DeltaLabo/cell_charger_discharger/pcb/cellSwitcherV6.xlsx

Part List |  |  |  |  |  |  |  | To take from inventory |  |  |  |  |  | To buy |  |  |  |  |  |  |  |  |  |  |  | FOR RS |  | FOR PBAN |  |  |  |  |  | SMD / DIP | Package
Qty | Name | Device | Value | Package | Parts | SMD / DIP | Pads / Pins | Bag | Available | Need | Balance | Specifications | Manufacturer | Vendor | Vendor SN | Manufacurer PN | Package type | Needed | Minimum | Actual | Inventory before | Inventory now | Unit cost | Total
4 | NPN transistor | BC818K-40 |  | SOT-23 | BJT1, BJT2, BJT3, BJT4 | SMD | 3 | A28 | 93 | 30 | 63 |  | Infineon |  |  | BC818K40E6327HTSA1 |  |  |  |  |  |  |  |  |  |  |  | Infineon | NPN transistor | BC818K40E6327HTSA1 | BJT1, BJT2, BJT3, BJT4 | 4 | 3 | SMD | SOT-23
1 | Non-polarized capacitor | NONPOL_CAP-0603 | 1n | C0603 | C1 | SMD | 2 | B37 | 93 | 12 | 81 |  | TDK |  |  | C1608X7R1H102K080AE |  |  |  |  |  |  |  |  |  |  |  | TDK | Non-polarized capacitor | C1608X7R1H102K080AE | C1 | 1 | 2 | SMD | C0603
2 | Non-polarized capacitor | NONPOL_CAP-0603 | 0.1u | C0603 | C2, C3 | SMD | 2 | B03 | 93 | 18 | 75 |  | TDK |  |  | C1608X8R1H104K080AB |  |  |  |  |  |  |  |  |  |  |  | TDK | Non-polarized capacitor | C1608X8R1H104K080AB | C2, C3 | 2 | 2 | SMD | C0603
1 | Non-polarized capacitor | NONPOL_CAP-0603 | 0.33u | C0603 | C4 | SMD | 2 | A25 | 34 | 12 | 22 |  | Murata |  |  | GRM21BR71C334KA01L |  |  |  |  |  |  |  |  |  |  |  | Murata | Non-polarized capacitor | GRM21BR71C334KA01L | C4 | 1 | 2 | SMD | C0603
1 | Non-polarized capacitor | NONPOL_CAP-0603 | 1u | C0603 | C5 | SMD | 2 | B04 | 8 | 12 | -4 |  | TDK |  |  | CGA4J3X7R1H105K125AB |  |  |  |  |  |  |  |  |  |  |  | TDK | Non-polarized capacitor | CGA4J3X7R1H105K125AB | C5 | 1 | 2 | SMD | C0603
1 | Non-polarized capacitor | NONPOL_CAP-0603 | 10u | C0603 | C6 | SMD | 2 | B06 | 32 | 12 | 20 |  | Murata |  |  | GRM188R61E106MA73D |  |  |  |  |  |  |  |  |  |  |  | Murata | Non-polarized capacitor | GRM188R61E106MA73D | C6 | 1 | 2 | SMD | C0603
2 | Li-Ion cell holder | 2_18650_HOLDER |  |  | CH1, CH2 | DIP | 2 | C1 | 12 | 9 | 3 |  | Keystone |  |  | 1049P |  |  |  |  |  |  |  |  |  |  |  | Keystone | Li-Ion cell holder | 1049P | CH1, CH2 | 2 | 2 | DIP
2 | Ni-MH cell holder | 2_AA_HOLDER |  |  | CH1, CH2 | DIP | 2 |  |  |  |  | Bulgin PCB mounting battery holder, AA size X 1 BX0035 AA battery 1 PCB | Bulgin | RS | 489-908 | BX0035 |  | 9 | 1 | 9 | 0 | 0 | ¥392.00 | ¥3528.00 | https://jp.rs-online.com/web/p/battery-holders-mounts/0489908/ | 489-908 | 9 | Bulgin | Ni-MH cell holder | BX0035 | CH1, CH2 | 2 | 2 | DIP
1 | Connector | TMM-110-01-F-D-RA |  |  | CON1 | DIP | 20 |  |  |  |  | 20 Positions Header Connector 0.079 "(2.00 mm) Through Hole, Right Angle Gold | SAMTEC | Digi-Key | TMM-110-01-FD-RA-ND | TMM-110-01-FD-RA |  | 12 | 1 | 12 | 0 | 0 | ¥229.00 | ¥2748.00 | https://www.digikey.jp/product-detail/ja/samtec-inc/TMM-110-01-F-D-RA/TMM-110-01-F-D-RA-ND/2685424 | TMM-110-01-FD-RA-ND | 12 | SAMTEC | Connector | TMM-110-01-FD-RA | CON1 | 1 | 20 | DIP
4 | Switching diode | BAQ133-GS08 |  | SOD08 | D1, D2, D3, D4 | SMD | 2 | A44 | 78 | 30 | 48 |  | Vishay |  |  | BAQ133-GS08 |  |  |  |  |  |  |  |  |  |  |  | Vishay | Switching diode | BAQ133-GS08 | D1, D2, D3, D4 | 4 | 2 | SMD | SOD08
1 | Fuse holder | FUSEHOLDER |  |  | F1 | DIP | 2 | A38 | 10 | 12 | -2 | Schurter PCB mounting fuse holder 10A for 5 x 20 mm cartridge fuse 250V ac 0031.8201 | Schurter | RS | 176-9047 | 31.8201 |  | 2 | 10 | 10 | 0 | 8 | ¥97.40 | ¥974.00 | https://jp.rs-online.com/web/p/pcb-mounts/1769047/ | 176-9047 | 10 | Schurter | Fuse holder | 31.8201 | F1 | 1 | 2 | DIP
4 | Relay | RTE24005F |  |  | K1, K2, K3, K4 | DIP | 8 | A66 | 24 | 30 | -6 | TE Connectivity Relay 5V dc, 2c contact PCB mounting type | TE Connectivity | RS | 782-1261 | RTE24005F |  | 6 | 1 | 6 | 0 | 0 | ¥316.00 | ¥1896.00 | https://jp.rs-online.com/web/p/pcb-mounts/1769047/ | 782-1261 | 6 | TE Connectivity | Relay | RTE24005F | K1, K2, K3, K4 | 4 | 8 | DIP
4 | LED | LGR971 |  | SML0805 | LED1, LED2, LED3, LED4 | SMD | 2 | A49 | 32 | 30 | 2 |  | OSRAM Opto Semiconductors |  |  | LGR971 |  |  |  |  |  |  |  |  |  |  |  | OSRAM Opto Semiconductors | LED | LGR971 | LED1, LED2, LED3, LED4 | 4 | 2 | SMD | SML0805
1 | Muxer | ADG704BRM |  | MSOP10 | MUX1 | SMD | 10 | A52 | 7 | 12 | -5 | Analog Devices Single 4: 1 Multiplexer 3 V, 5 V, 10-Pin MSOP | Analog Devices | RS | 523-8761 | ADG704BRMZ |  | 5 | 1 | 5 | 0 | 0 | ¥327.00 | ¥1635.00 | https://jp.rs-online.com/web/p/multiplexer-switch-ics/5238761/ | 523-8761 | 5 | Analog Devices | Muxer | ADG704BRMZ | MUX1 | 1 | 10 | SMD | MSOP10
1 | NAND gate | SN74LVC2G00DCUT |  | VSSOP-8 | NAND1 | SMD | 8 | A48 | 16 | 12 | 4 |  | Texas Instruments |  |  | SN74LVC2G00DCUT |  |  |  |  |  |  |  |  |  |  |  | Texas Instruments | NAND gate | SN74LVC2G00DCUT | NAND1 | 1 | 8 | SMD | VSSOP-8
1 | OptoCoupler | PS2502-4 |  | DIL16 | OK1 | DIP | 16 | A50 | 12 | 12 | 0 |  | Renesas Electronics |  |  | PS2502-4-A |  |  |  |  |  |  |  |  |  |  |  | Renesas Electronics | OptoCoupler | PS2502-4-A | OK1 | 1 | 16 | DIP | DIL16
4 | Resistor | RESISTOR-0603 | 1k | R0603 | R1, R2, R3, R4 | SMD | 2 |  |  |  |  | TE Connectivity Thick Film Surface Mount Resistors, 0.1 W, 1 kΩ, ± 1% | TE Connectivity | RS | 213-2266 | CRG0603F1K0 |  | 30 | 50 | 50 | 0 | 20 | ¥3.90 | ¥195.00 | https://jp.rs-online.com/web/p/surface-mount-fixed-resistors/2132266 | 213-2266 | 50 | TE Connectivity | Resistor | CRG0603F1K0 | R1, R2, R3, R4 | 4 | 2 | SMD | R0603
4 | Resistor | RESISTOR-0603 | 510 | R0603 | R1.1, R2.1, R3.1, R4.1 | SMD | 2 | A93 | 29 | 30 | -1 |  | Vishay |  |  | CRCW0603510RFKEA |  |  |  |  |  |  |  |  |  |  |  | Vishay | Resistor | CRCW0603510RFKEA | R1.1, R2.1, R3.1, R4.1 | 4 | 2 | SMD | R0603
1 | Resistor | RESISTOR-0603 | 0 | R0603 | R5 | SMD | 2 | B22 | 27 | 12 | 15 |  | Vishay |  |  | CRCW06030000Z0EB |  |  |  |  |  |  |  |  |  |  |  | Vishay | Resistor | CRCW06030000Z0EB | R5 | 1 | 2 | SMD | R0603
1 | Regulator | NCV7805BD2TG |  | D2PAK-3 | REG2 | SMD | 3 | B32 | 27 | 12 | 15 |  | ON Semiconductor |  |  | NCV7805BD2TG |  |  |  |  |  |  |  |  |  |  |  | ON Semiconductor | Regulator | NCV7805BD2TG | REG2 | 1 | 3 | SMD | D2PAK-3
4 | Temperature sensor | STLM20DD9F |  | UDFN-4L | TS1, TS2, TS3, TS4 | SMD | 4 |  |  |  |  | STMicroelectronics Temperature Sensor IC, ± 1.5 ° C, Analog, 2.4 to 5.5 V, 4-Pin UDFN Temperature | STMicroelectronics | RS | 686-4973 | STLM20DD9F | UDFN-4L | 30 | 5 | 30 | 0 | 0 | ¥90.80 | ¥2724.00 | https://jp.rs-online.com/web/p/temperature-sensors-humidity-sensors/6864973/ | 686-4973 | 30 | STMicroelectronics | Temperature sensor | STLM20DD9F | TS1, TS2, TS3, TS4 | 4 | 4 | SMD | UDFN-4L
3 | Fuses |  | 4A |  |  |  |  |  |  |  |  | Littelfuse glass tube fuse 4A (time lag) 239 series 5x20mm 5 x 20mm 125V ac | Littlefuse | RS | 523-4725 | 0239004.MXP |  | 24 | 30 | 30 | 0 | 6 | ¥81.40 | ¥2442.00 | https://jp.rs-online.com/web/p/cartridge-fuses/5234725/ | 523-4725 | 30
1 | PCB fabrication |  |  |  |  |  |  |  |  |  |  | PCB fabrication - 2 layers - With soldering service | P-ban | P-ban |  |  |  | 1 | 1 | 1 | 0 | 0 |  | ¥0.00
TOTAL |  | ¥16142.00
