DeltaLabo/cell_charger_discharger/pcb/chargerDischarger.V5.xlsx

Part List |  |  |  |  |  |  |  | To take from inventory |  |  |  |  |  | To buy |  |  |  |  |  |  |  |  |  |  |  | FOR RS |  | FOR PBAN |  |  |  |  |  | SMD / DIP | Package
Qty | Name | Device | Value | Package | Parts | SMD / DIP | Leads / Pins | Bag | Available | Need | Balance | Specifications | Manufacturer | Vendor | Vendor SN | Manufacurer PN | Package type | Needed | Minimum | Actual | Inventory before | Inventory now | Unit cost | Total
3 | NPN transistor | BC818K-40 |  | SOT-23 | BJT101, BJT102, BJT103 | SMD | 3 | A28 | 105 | 12 | 93 |  | Infineon |  |  | BC818K40E6327HTSA1 | SOT-23 |  |  |  |  |  |  |  |  |  |  | Infineon | NPN transistor | BC818K40E6327HTSA1 | BJT101, BJT102, BJT103 | 3 | 3 | SMD | SOT-23
13 | Non-polarized capacitor | NONPOL_CAP-0603 | 1u | C0603 | C1, C3, C5, C6, C7, C101, C102, C103, C210, C214, C302, C304, C403 | SMD | 2 | B33 |  |  |  | TDK MLCC 1μF 50V dc ± 10% | TDK | RS | 903-8720 | CGA4J3X7R1H105K125AB | C0603 | 42 | 50 | 50 | 0 | 8 | ¥26.76 | ¥1338.00 | https://jp.rs-online.com/web/p/mlccs-multilayer-ceramic-capacitors/9038720/ | 903-8720 | 50 | TDK | Non-polarized capacitor | CGA4J3X7R1H105K125AB | C1, C3, C5, C6, C7, C101, C102, C103, C210, C214, C302, C304, C403 | 13 | 2 | SMD | C0603
4 | Non-polarized capacitor | NONPOL_CAP-0603 | 10u | C0603 | C2, C10, C303, C405 | SMD | 2 |  |  |  |  | Murata MLCC 10μF 25V dc ± 20% | Murata | RS | 790-2723 | GRM188R61E106MA73D | C0603 | 15 | 25 | 25 | 0 | 10 | ¥29.12 | ¥728.00 | https://jp.rs-online.com/web/p/mlccs-multilayer-ceramic-capacitors/7902723/ | 790-2723 | 25 | Murata | Non-polarized capacitor | GRM188R61E106MA73D | C2, C10, C303, C405 | 4 | 2 | SMD | C0603
3 | Non-polarized capacitor | NONPOL_CAP-0603 | 10u | C1210 | C201, C202, C203 | SMD | 2 |  |  |  |  | TDK MLCC 10μF 50V dc ± 10% | TDK | RS | 915-5446 | CGA6P3X7S1H106K250AE | C1210 | 12 | 25 | 25 | 0 | 13 | ¥210.20 | ¥5255.00 | https://jp.rs-online.com/web/p/mlccs-multilayer-ceramic-capacitors/9155446/ | 915-5446 | 25 | TDK | Non-polarized capacitor | CGA6P3X7S1H106K250AE | C201, C202, C203 | 3 | 2 | SMD | C1210
6 | Polarized capacitor | POL_CAP-7343 | 33u | C7343 | C204, C205, C206, C215, C216, C217 | SMD | 2 | A82 |  |  |  | KEMET 33μF 25V dc Tantalum Capacitor Polymer Solid ±20% Tolerance T521 Series | KEMET | RS | 121-3317 | T521D336M025ATE040 | C7343 | 21 | 50 | 50 | 0 | 29 | ¥121.40 | ¥6070.00 | https://jp.rs-online.com/web/p/tantalum-capacitors/1213317/ | 121-3317 | 50 | KEMET | Polarized capacitor | T521D336M025ATE040 | C204, C205, C206, C215, C216, C217 | 6 | 2 | SMD | C7343
1 | Non-polarized capacitor | NONPOL_CAP-0603 | 10n | C0603 | C211 | SMD | 2 | A85 | 95 | 6 | 89 |  | Murata |  |  | GRM1885C1H103JA01D | C0603 |  |  |  |  |  |  |  |  |  |  | Murata | Non-polarized capacitor | GRM1885C1H103JA01D | C211 | 1 | 2 | SMD | C0603
6 | Non-polarized capacitor | NONPOL_CAP-0603 | 0.1u | C0603 | C4, C207, C218, C305, C501, C502 | SMD | 2 |  |  |  |  | TDK MLCC 100nF 50V dc ± 10% | TDK | RS | 915-9237 | C1608X8R1H104K080AB | C0603 | 21 | 100 | 100 | 0 | 79 | ¥7.74 | ¥774.00 | https://jp.rs-online.com/web/p/mlccs-multilayer-ceramic-capacitors/9159237 | 915-9237 | 100 | TDK | Non-polarized capacitor | C1608X8R1H104K080AB | C4, C207, C218, C305, C501, C502 | 6 | 2 | SMD | C0603
1 | Non-polarized capacitor | NONPOL_CAP-0603 | 0.33u | C0603 | C401 | SMD | 2 | A25 | 95 | 6 | 89 |  | Murata |  |  | GRM21BR71C334KA01L | C0603 |  |  |  |  |  |  |  |  |  |  | Murata | Non-polarized capacitor | GRM21BR71C334KA01L | C401 | 1 | 2 | SMD | C0603
1 | Non-polarized capacitor | POL_CAP-7343 | 100u | D6.3_AEC | C601 | SMD | 2 | A86 | 6 | 6 | 0 |  | Nichicon |  |  | UWT1C101MCL1GB | D6.3_AEC |  |  |  |  |  |  |  |  |  |  | Nichicon | Non-polarized capacitor | UWT1C101MCL1GB | C601 | 1 | 2 | SMD | D6.3_AEC
1 | Non-polarized capacitor | NONPOL_CAP-0603 | 1n | C0603 | C8 | SMD | 2 |  |  |  |  | TDK MLCC 1nF 50V dc ± 10% | TDK | RS | 915-9211 | C1608X7R1H102K080AE | C0603 | 6 | 100 | 100 | 0 | 94 | ¥5.98 | ¥598.00 | https://jp.rs-online.com/web/p/mlccs-multilayer-ceramic-capacitors/9159211 | 915-9211 | 100 | TDK | Non-polarized capacitor | C1608X7R1H102K080AE | C8 | 1 | 2 | SMD | C0603
1 | Audio jack | AUDIO_JACK-3.5MM |  |  | COMM | DIP | 4 | A87 | 2 | 6 | -4 | Lumberg phone jack (female) 3.5 mm through-hole stereo | Lumberg | RS | 505-1479 | KLBR 4 |  | 4 | 1 | 4 | 0 | 0 | ¥280.00 | ¥1120.00 | https://jp.rs-online.com/web/p/jack-plugs/5051479 | 505-1479 | 4 | Lumberg | Audio jack | KLBR 4 | COMM | 1 | 4 | DIP
1 | Connector | B6B-EH-A |  |  | CON1 | DIP | 6 | A88 | 2 | 6 | -4 | Pin header for JST board connection EH series 6 poles 2.5 mm single row straight | JST | RS | 515-1434 | B6B-EH-A (LF) (SN) |  | 4 | 10 | 10 | 0 | 6 | ¥25.50 | ¥255.00 | https://jp.rs-online.com/web/p/pcb-headers/5151434 | 515-1434 | 10 | JST | Connector | B6B-EH-A (LF) (SN) | CON1 | 1 | 6 | DIP
1 | Connector | SQT-110-01-F-D-RA |  |  | CON2 | DIP | 20 |  |  |  |  | Samtec Discrete Socket SQT Series 2mm 20 Pole 2 Row Through Hole SQT-110-01-FD-RA | SAMTEC | RS | 180-1847 | SQT-110-01-FD-RA |  | 6 | 1 | 6 | 0 | 0 | ¥467.00 | ¥2802.00 | https://jp.rs-online.com/web/p/pcb-sockets/1801847/ | 180-1847 | 6 | SAMTEC | Connector | SQT-110-01-FD-RA | CON2 | 1 | 20 | DIP
3 | Switching diode | BAQ133-GS08 |  | SOD08 | D101, D102, D103 | SMD | 2 | A44 | 90 | 12 | 78 |  | Vishay |  |  | BAQ133-GS08 | SOD08 |  |  |  |  |  |  |  |  |  |  | Vishay | Switching diode | BAQ133-GS08 | D101, D102, D103 | 3 | 2 | SMD | SOD08
1 | Schottky diode | SCHOTTKY_DIODE-BAT42W |  | SOD123 | D202 | SMD | 2 | A26 | 97 | 6 | 91 |  | DiodesZetex |  |  | BAT42W-7-F | SOD123 |  |  |  |  |  |  |  |  |  |  | DiodesZetex | Schottky diode | BAT42W-7-F | D202 | 1 | 2 | SMD | SOD123
1 | Op-Amp | MAX4198 |  | SOIC-8 | DA501 | SMD | 8 | A92 | 3 | 6 | -3 | IC OPAMP DIFF 1 CIRCUIT 8SOIC | Maxim Integrated | Digi-Key | MAX4198ESA+-ND | MAX4198ESA+-ND | SOIC-8 | 3 | 1 | 3 | 0 | 0 | ¥347.00 | ¥1041.00 | https://www.digikey.com/product-detail/en/maxim-integrated/MAX4198ESA/MAX4198ESA-ND/1702090 | MAX4198ESA+-ND | 3 | Maxim Integrated | Op-Amp | MAX4198ESA+-ND | DA501 | 1 | 8 | SMD | SOIC-8
1 | Dual MOSFET Driver | MCP14628-E/SN |  | SOIC-8 | DR200 | SMD | 8 |  |  |  |  | Microchip MOSFET Driver Dual 2A, 4.5-5.5V 8-Pin SOIC Inverted, Non-Inverted MCP14628-E / SN | Microchip | RS | 668-4219 | MCP14628-E / SN | SOIC-8 | 6 | 2 | 6 | 0 | 0 | ¥205.50 | ¥1233.00 | https://jp.rs-online.com/web/p/mosfet-drivers/6684219 | 668-4219 | 6 | Microchip | Dual MOSFET Driver | MCP14628-E / SN | DR200 | 1 | 8 | SMD | SOIC-8
2 | Fuse holder | FUSEHOLDER |  |  | F1,F2 | DIP | 2 | A38 | 19 | 9 | 10 |  | Schurter |  |  | 31.8201 |  |  |  |  |  |  |  |  |  |  |  | Schurter | Fuse holder | 31.8201 | F1,F2 | 2 | 2 | DIP
1 | Common mode choke | ACM9070-701 |  |  | FIL601 | SMD | 4 |  |  |  |  | TDK common mode choke coil ACM 10 mΩ | TDK | RS | 916-4144 | ACM9070-701-2PL-TL01 |  | 6 | 2 | 6 | 0 | 0 | ¥247.00 | ¥1482.00 | https://jp.rs-online.com/web/p/emi-rfi-inductor-components/9164144/ | 916-4144 | 6 | TDK | Common mode choke | ACM9070-701-2PL-TL01 | FIL601 | 1 | 4 | SMD
1 | Relay | ORWH |  |  | K101 | DIP | 5 | A72 | 8 | 6 | 2 |  | TE Connectivity |  |  | ORWH-SH-105D1F |  |  |  |  |  |  |  |  |  |  |  | TE Connectivity | Relay | ORWH-SH-105D1F | K101 | 1 | 5 | DIP
1 | Relay | RT424F05054 |  |  | K102 | DIP | 9 |  |  |  |  | TE Connectivity Latching Relay DPDT 5V dc | TE Connectivity | RS | 680-3883P | RT424F05 |  | 6 | 1 | 6 | 0 | 0 | ¥870.00 | ¥5220.00 | https://jp.rs-online.com/web/p/latching-relays/6803883P/ | 680-3883P | 6 | TE Connectivity | Relay | RT424F05 | K102 | 1 | 9 | DIP
2 | Power Inductor | INDUCTOR-60B8683C | 68u |  | L203, L204 | SMD | 2 |  |  |  |  | Murata Power Solutions Wirewound Inductors (face mount), 68 μH, 9A, 27 x 19.5 x 20 mm | Murata | RS | 749-6405 | 60B683C |  | 9 | 1 | 9 | 0 | 0 | ¥356.00 | ¥3204.00 | https://jp.rs-online.com/web/p/wire-wound-surface-mount-inductors/7496405/ | 749-6405 | 9 | Murata | Power Inductor | 60B683C | L203, L204 | 2 | 2 | SMD
3 | LED | LGR971 |  | SML0805 | LED101, LED102, LED103 | SMD | 2 | A49 | 44 | 12 | 32 |  | OSRAM |  |  | LGR971 | SML0805 |  |  |  |  |  |  |  |  |  |  | OSRAM | LED | LGR971 | LED101, LED102, LED103 | 3 | 2 | SMD | SML0805
2 | N-Channel MOSFET | SI4154DY |  | SOIC-8 | MF201, MF202 | SMD | 8 |  |  |  |  | N-Ch MOSFET SO-8 BWL 40 V 3.3 mohm @ 10 V- | Vishay | RS | 180-7965 | SI4154DY-T1-GE3 | SOIC-8 | 9 | 10 | 10 | 0 | 1 | ¥175.80 | ¥1758.00 | https://jp.rs-online.com/web/p/mosfets/1807965/ | 180-7965 | 10 | Vishay | N-Channel MOSFET | SI4154DY-T1-GE3 | MF201, MF202 | 2 | 8 | SMD | SOIC-8
3 | OptoCoupler | PS2502-1 |  | DIL04 | OK101, OK102, OK103 | DIP | 4 |  |  |  |  | Isocom Photocoupler AC input 1, 4-Pin through hole mounting | Isocom | RS | 161-1266 | PS2502-1X | DIL04 | 12 | 20 | 20 | 0 | 8 | ¥64.65 | ¥1293.00 | https://jp.rs-online.com/web/p/optocouplers/1611266/ | 161-1266 | 20 | Isocom | OptoCoupler | PS2502-1X | OK101, OK102, OK103 | 3 | 4 | DIP | DIL04
1 | Power jack | 722RA |  |  | PC1 | DIP | 3 |  |  |  |  | Switchcraft DC Power Socket 2mm 5A Through Hole 12 V dc 722RA | Switchcraft | RS | 705-1516 | 722RA |  | 6 | 1 | 6 | 0 | 0 | ¥345.00 | ¥2070.00 | https://jp.rs-online.com/web/p/optocouplers/1611266/ | 705-1516 | 6 | Switchcraft | Power jack | 722RA | PC1 | 1 | 3 | DIP
1 | 8-bit MCU | PIC16F1786-I/SS |  | SPDIP-28 | PIC1 | DIP | 28 |  |  |  |  | Microchip Microcomputer PIC16F 8-bit RISC, 28-Pin SDPIP | Microchip | RS | 803-2434 | PIC16F1786-I / SP | SPDIP-28 | 6 | 10 | 10 | 0 | 4 | ¥311.00 | ¥3110.00 | https://jp.rs-online.com/web/p/microcontrollers/8032434 | 803-2434 | 10 | Microchip | 8-bit MCU | PIC16F1786-I / SP | PIC1 | 1 | 28 | DIP | SPDIP-28
3 | Power Resistor | TO-220_RESISTOR | 1 | TO-220 | PR701, PR702, PR703 | DIP | 4 |  |  |  |  | Vishay Power Resistor LTO 50 Series 1 Ω 50 W ą 5% | Vishay | RS | 532-8369 | LTO 050 F 1 R 000 JTE 3 | TO-220 | 12 | 1 | 12 | 0 | 0 | ¥838.00 | ¥10056.00 | https://jp.rs-online.com/web/p/through-hole-fixed-resistors/5328369/ | 532-8369 | 12 | Vishay | Power Resistor | LTO 050 F 1 R 000 JTE 3 | PR701, PR702, PR703 | 3 | 4 | DIP | TO-220
2 | Resistor | RESISTOR-0603 | 0 | R0603 | R1, R2 | SMD | 2 | B22 |  |  |  | Vishay thick film surface mount resistor, 0.1 W, 0 Ω, ± 1% | Vishay | RS | 678-9670 | CRCW06030000Z0EB | R0603 | 9 | 50 | 50 | 0 | 41 | ¥1.34 | ¥67.00 | https://jp.rs-online.com/web/p/surface-mount-fixed-resistors/6789670/ | 678-9670 | 50 | Vishay | Resistor | CRCW06030000Z0EB | R1, R2 | 2 | 2 | SMD | R0603
4 | Resistor | RESISTOR-0603 | 1k | R0603 | R101, R103, R106, R202 | SMD | 2 | A21 | 26 | 15 | 11 |  | TE Connectivity |  |  | CRG0603F1K0 | R0603 |  |  |  |  |  |  |  |  |  |  | TE Connectivity | Resistor | CRG0603F1K0 | R101, R103, R106, R202 | 4 | 2 | SMD | R0603
3 | Resistor | RESISTOR-0603 | 510 | R0603 | R102, R104, R107 | SMD | 2 | A93 | 41 | 12 | 29 |  | Vishay |  |  | CRCW0603510RFKEA | R0603 |  |  |  |  |  |  |  |  |  |  | Vishay | Resistor | CRCW0603510RFKEA | R102, R104, R107 | 3 | 2 | SMD | R0603
1 | Resistor | RESISTOR-0603 | 10M | R0603 | R105 | SMD | 2 | A22 | 40 | 6 | 34 |  | Vishay |  |  | CRCW060310M0FKEA | R0603 |  |  |  |  |  |  |  |  |  |  | Vishay | Resistor | CRCW060310M0FKEA | R105 | 1 | 2 | SMD | R0603
1 | Resistor | RESISTOR-0603 | 200 | R0603 | R4 | SMD | 2 |  |  |  |  | KOA Thick Film Surface Mount Resistors, 0.125 W, 200 Ω, ± 1% | KOA | RS | 631-6222 | RK73H1JTTD2000F | R0603 | 6 | 50 | 50 | 0 | 44 | ¥7.96 | ¥398.00 | https://jp.rs-online.com/web/p/surface-mount-fixed-resistors/6316222/ | 631-6222 | 50 | KOA | Resistor | RK73H1JTTD2000F | R4 | 1 | 2 | SMD | R0603
1 | Regulator | NCV7805BD2TG |  | D2PAK-3 | REG402 | SMD | 3 |  |  |  |  | ON Semiconductor Positive Voltage 3-Terminal Regulator 5 V 1A Fixed Output Surface Mount D2PAK 3-Pin | ON Semiconductor | RS | 785-7428 | NCV7805BD2TG | D2PAK-3 | 6 | 10 | 10 | 0 | 4 | ¥82.20 | ¥822.00 | https://jp.rs-online.com/web/p/linear-voltage-regulators/7857428 | 785-7428 | 10 | ON Semiconductor | Regulator | NCV7805BD2TG | REG402 | 1 | 3 | SMD | D2PAK-3
1 | Hall-effect current sensor | ACS723-05AB-T |  | SOIC-8 | SEN301 | SMD | 8 |  |  |  |  | Hall-effect current sensor IC, 8-pin SOIC | Allegro Microsystems | RS | 866-0767 | ACS723LLCTR-05AB-T | SOIC-8 | 6 | 10 | 10 | 0 | 4 | ¥647.00 | ¥6470.00 | https://jp.rs-online.com/web/p/current-sensors/8660767/ | 866-0767 | 10 | Allegro Microsystems | Hall-effect current sensor | ACS723LLCTR-05AB-T | SEN301 | 1 | 8 | SMD | SOIC-8
2 | Voltage reference | REF195GSZ |  | SOIC-8 | VREF1, VREF302 | SMD | 8 |  |  |  |  | Analog Devices Reference Voltage IC, Output: 5V Surface Mount, 8-pin SOIC | Analog Devices | RS | 523-7011 | REF195GSZ | SOIC-8 | 9 | 10 | 10 | 0 | 1 | ¥400.00 | ¥4000.00 | https://jp.rs-online.com/web/p/voltage-references/5237011/ | 523-7011 | 10 | Analog Devices | Voltage reference | REF195GSZ | VREF1, VREF302 | 2 | 8 | SMD | SOIC-8
3 | Heatsink |  |  |  |  |  |  |  |  |  |  | For RS Pro heat sink transistor, 20 x 35 x 20 mm | RS Pro | RS | 263-251 | 263-251 |  | 10 | 10 | 10 | 0 | 0 | ¥224.00 | ¥2240.00 | https://jp.rs-online.com/web/p/heatsinks/0263251/ | 263-251 | 10
1 | FTDI chip |  |  |  |  |  |  |  |  |  |  | FTDI Chip Interface Development Kit 5 V TTL 3.5 mm Jack USB-UART Cable | FTDI Chip | RS | 687-7774 | TTL-232R-5V-AJ |  | 3 | 1 | 3 | 0 | 0 | ¥2397.00 | ¥7191.00 | https://jp.rs-online.com/web/p/interface-development-kits/6877774/ | 687-7774 | 3
1 | Adaptor |  |  |  |  |  |  |  |  |  |  | 7.5V 24W AC/DC External Wall Mount Adapter Fixed Blade Input | Triad Magnetics | Digi-Key | 237-1391-ND | WSU075-3200 |  | 4 | 1 | 4 | 0 | 0 | ¥1891.00 | ¥7564.00 | https://www.digikey.jp/products/en?keywords=237-1391-ND | 237-1391-ND | 4
1 | PCB fabrication |  |  |  |  |  |  |  |  |  |  | PCB fabrication - 2 layers - With soldering service | P-ban | P-ban |  |  |  | 1 | 1 | 1 | 0 | 0 |  | ¥0.00 |  |  | 1
TOTAL |  | ¥78159.00
