DeltaLabo/cell_charger_discharger/calibration/Voltage_Calibration_Disc.png

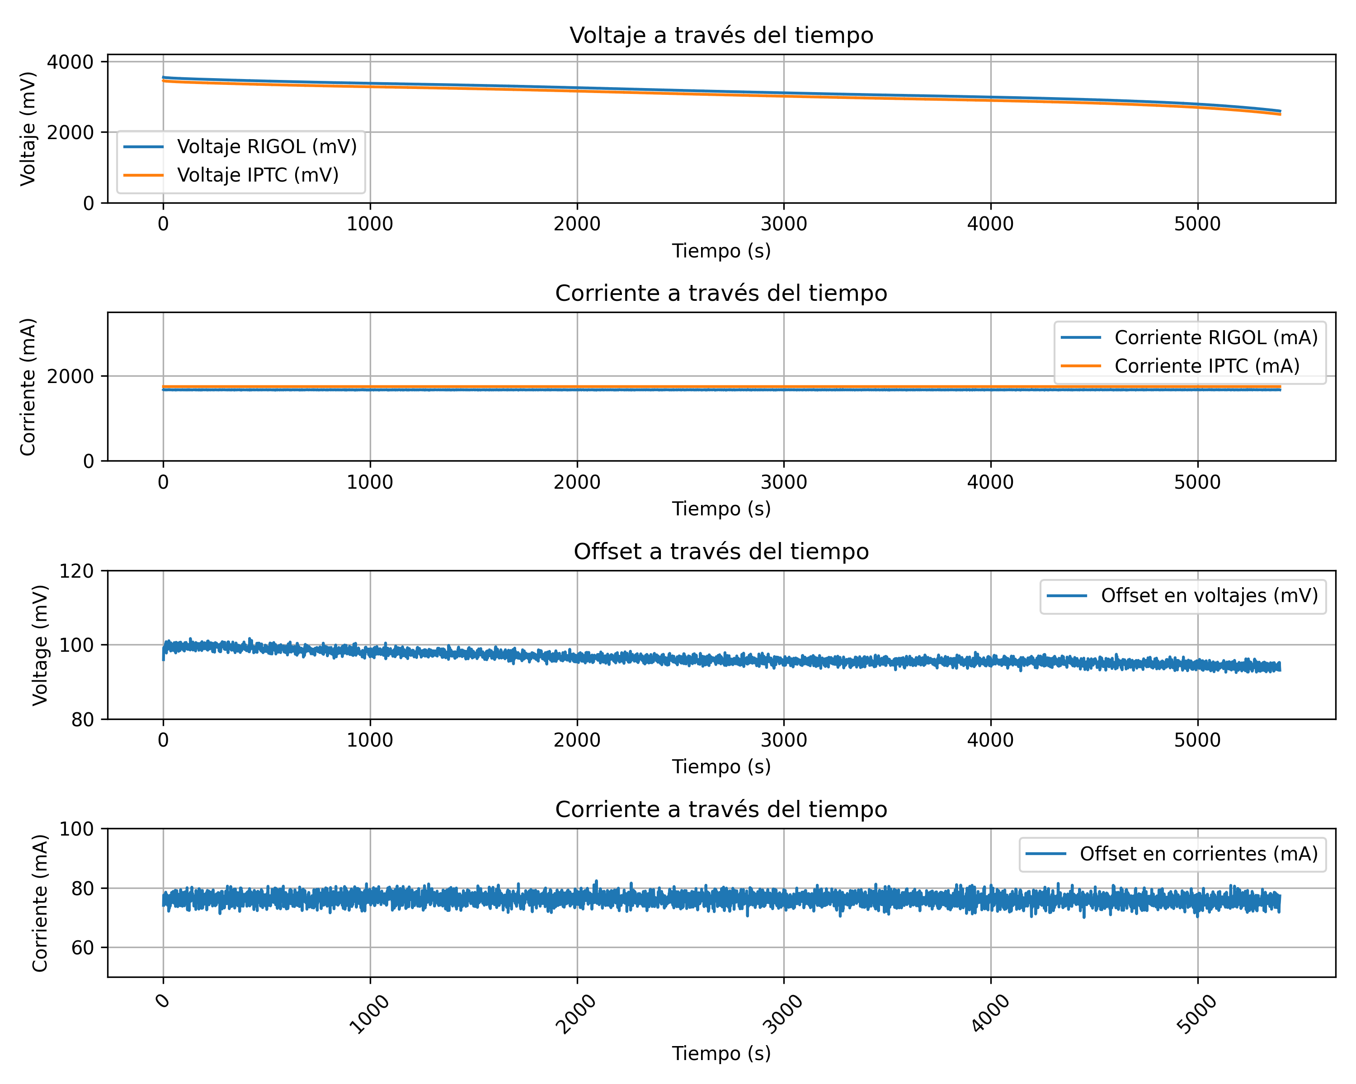
calibration/Voltage_Calibration_Disc.png
