DeltaLabo/cell_charger_discharger/pcb/cellSwitcher_ni_mh_V6_schematic.pdf

# General Block Diagram RTE²⁴⁰⁰⁵F RTE²⁴⁰⁰⁵F RTE²⁴⁰⁰⁵F RTE²⁴⁰⁰⁵F

CON1P1 CON1P2 CON1P3 CON1P4 CON1P5 CON1P6 CON1P7 CON1P8 CON1P9 CON1P10 CON1P11 CON1P12 CON1P13 CON1P14 CON1P15 CON1P16 CON1P17 CON1P18 CON1P19 CON1P20

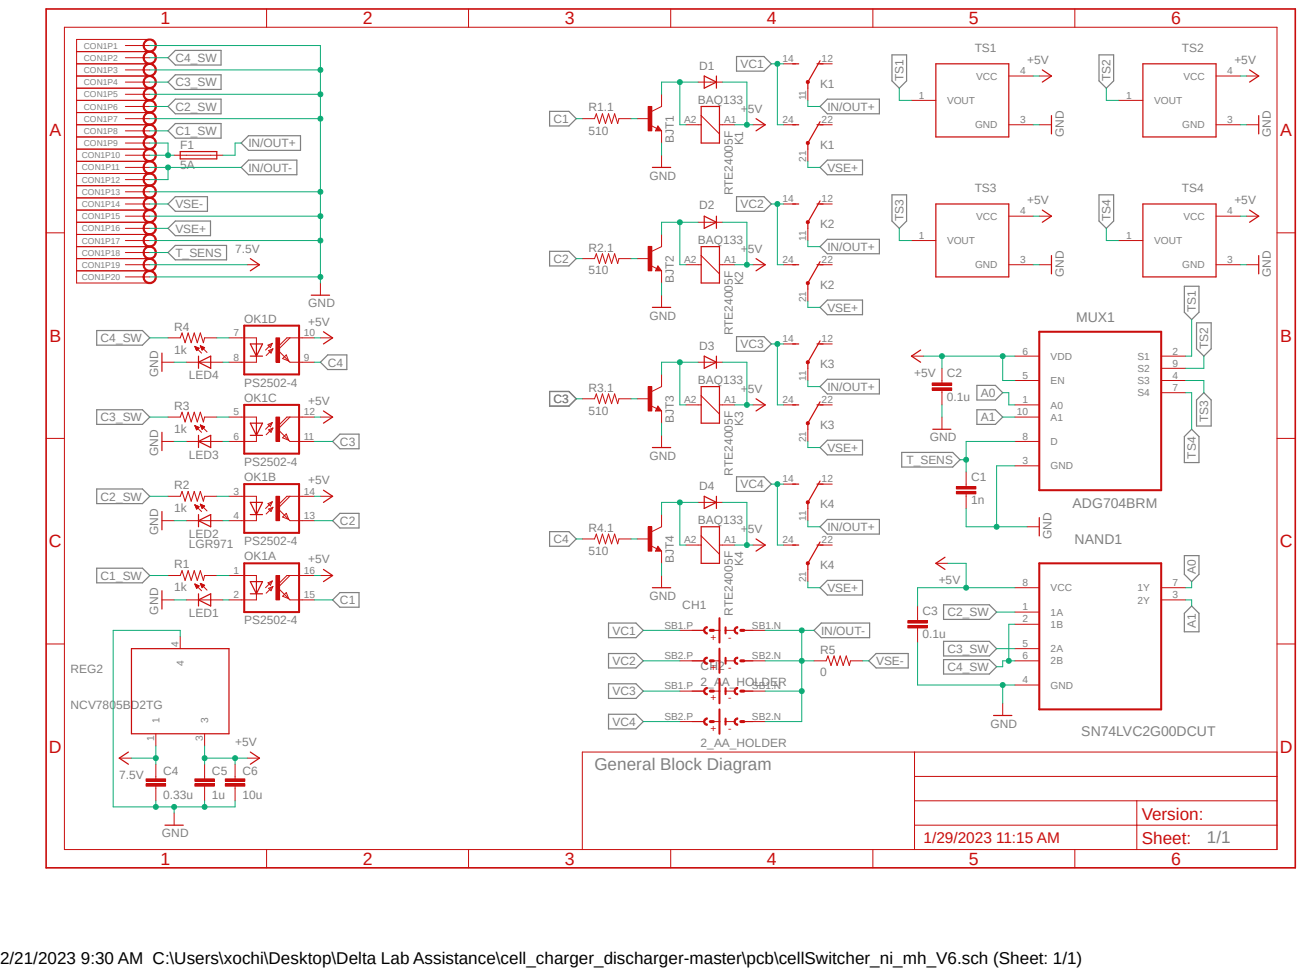
[picture p2: page 1]

2/21/2023 9:30 AM C:\Users\xochi\Desktop\Delta Lab Assistance\cell_charger_discharger-master\pcb\cellSwitcher_ni_mh_V6.sch (Sheet: 1/1)
