DeltaLabo/cell_charger_discharger/pcb/cellChargerDischarger_li_ion_V6_board.pdf

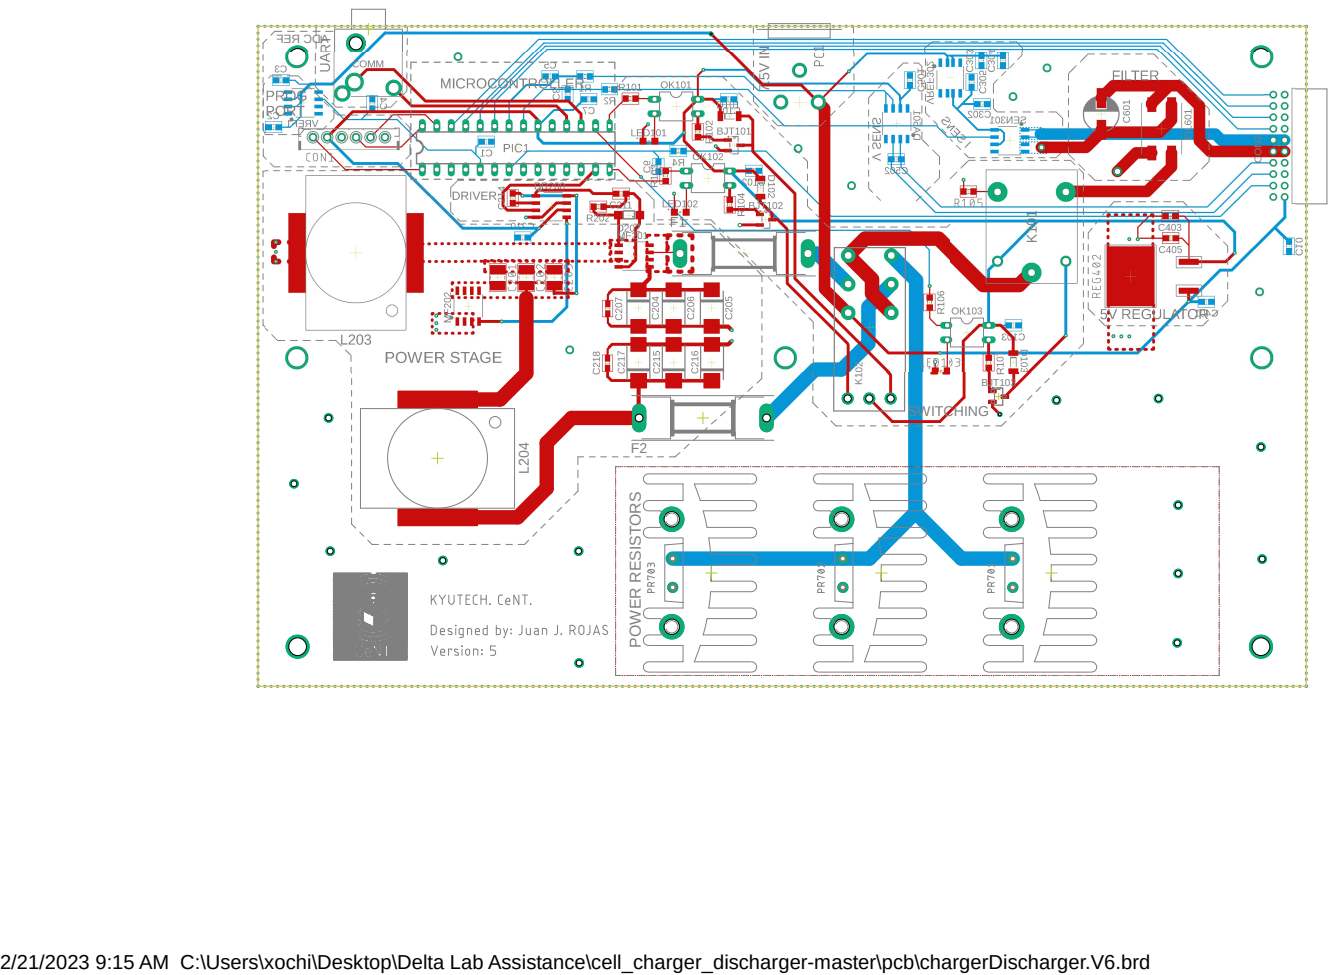
[picture p3: page 1]
2/21/2023 9:15 AM C:\Users\xochi\Desktop\Delta Lab Assistance\cell_charger_discharger-master\pcb\chargerDischarger.V6.brd; C¹⁰; SWITCHING POWER RESISTORS C²¹⁷; C²¹⁵; C²¹⁶ L204; F2 C²¹⁸; K¹⁰²; R¹⁰⁷ BJT103
