DeltaLabo/cell_charger_discharger/pcb/cellSwitcher_ni_mh_V6_board.pdf

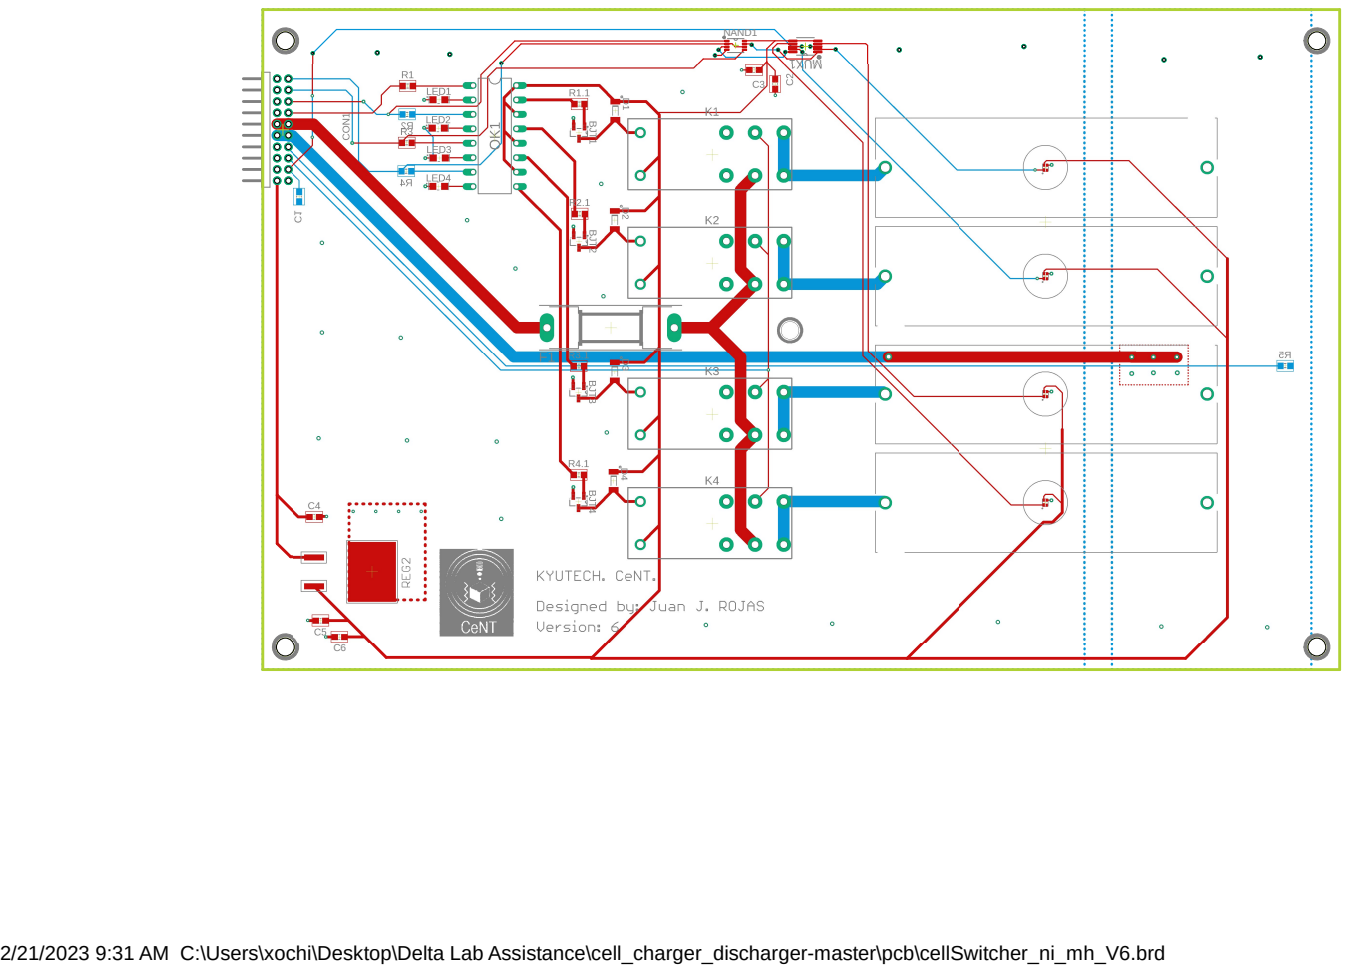
[picture p4: page 1]
NAND1; MUX1

2/21/2023 9:31 AM C:\Users\xochi\Desktop\Delta Lab Assistance\cell_charger_discharger-master\pcb\cellSwitcher_ni_mh_V6.brd C¹
