DeltaLabo/cell_charger_discharger/pcb/cellChargerDischarger_li_ion_V6_schematic.pdf

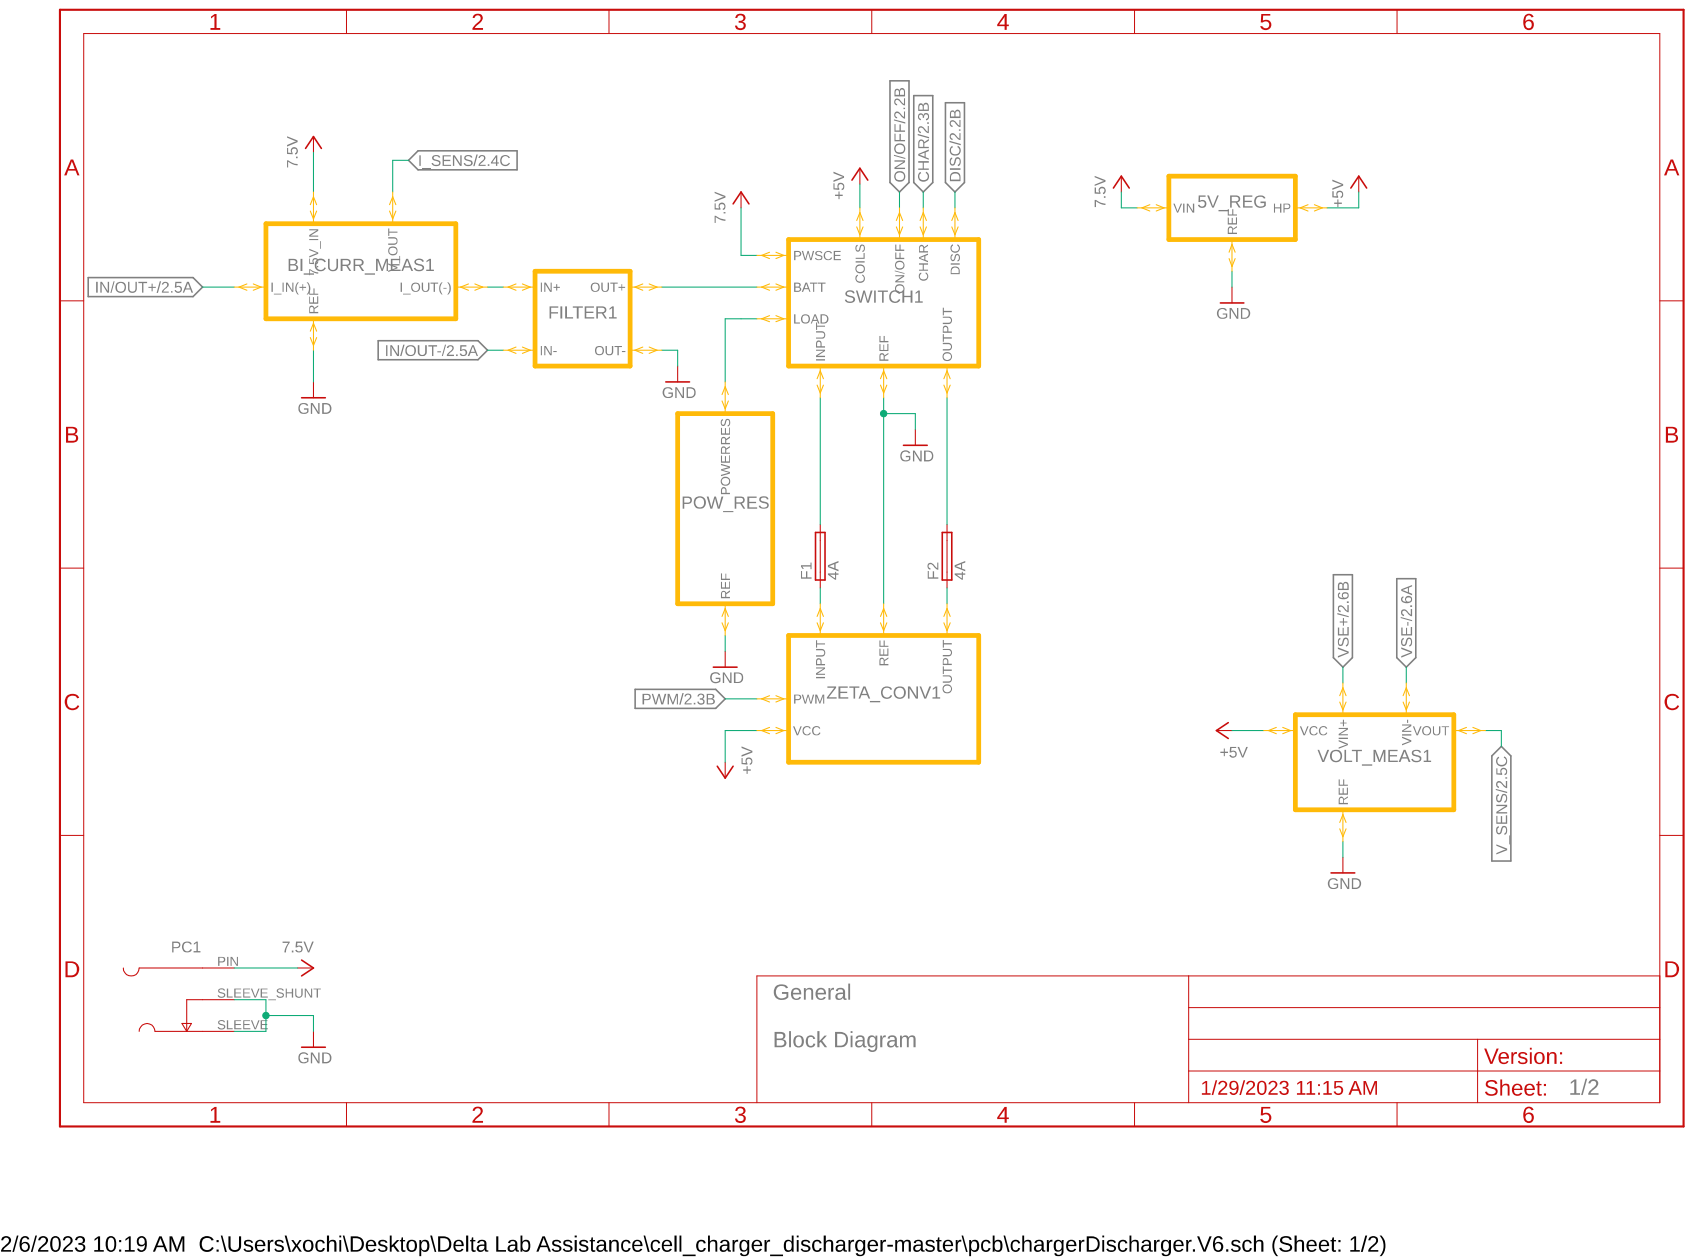
[picture p5: page 1]

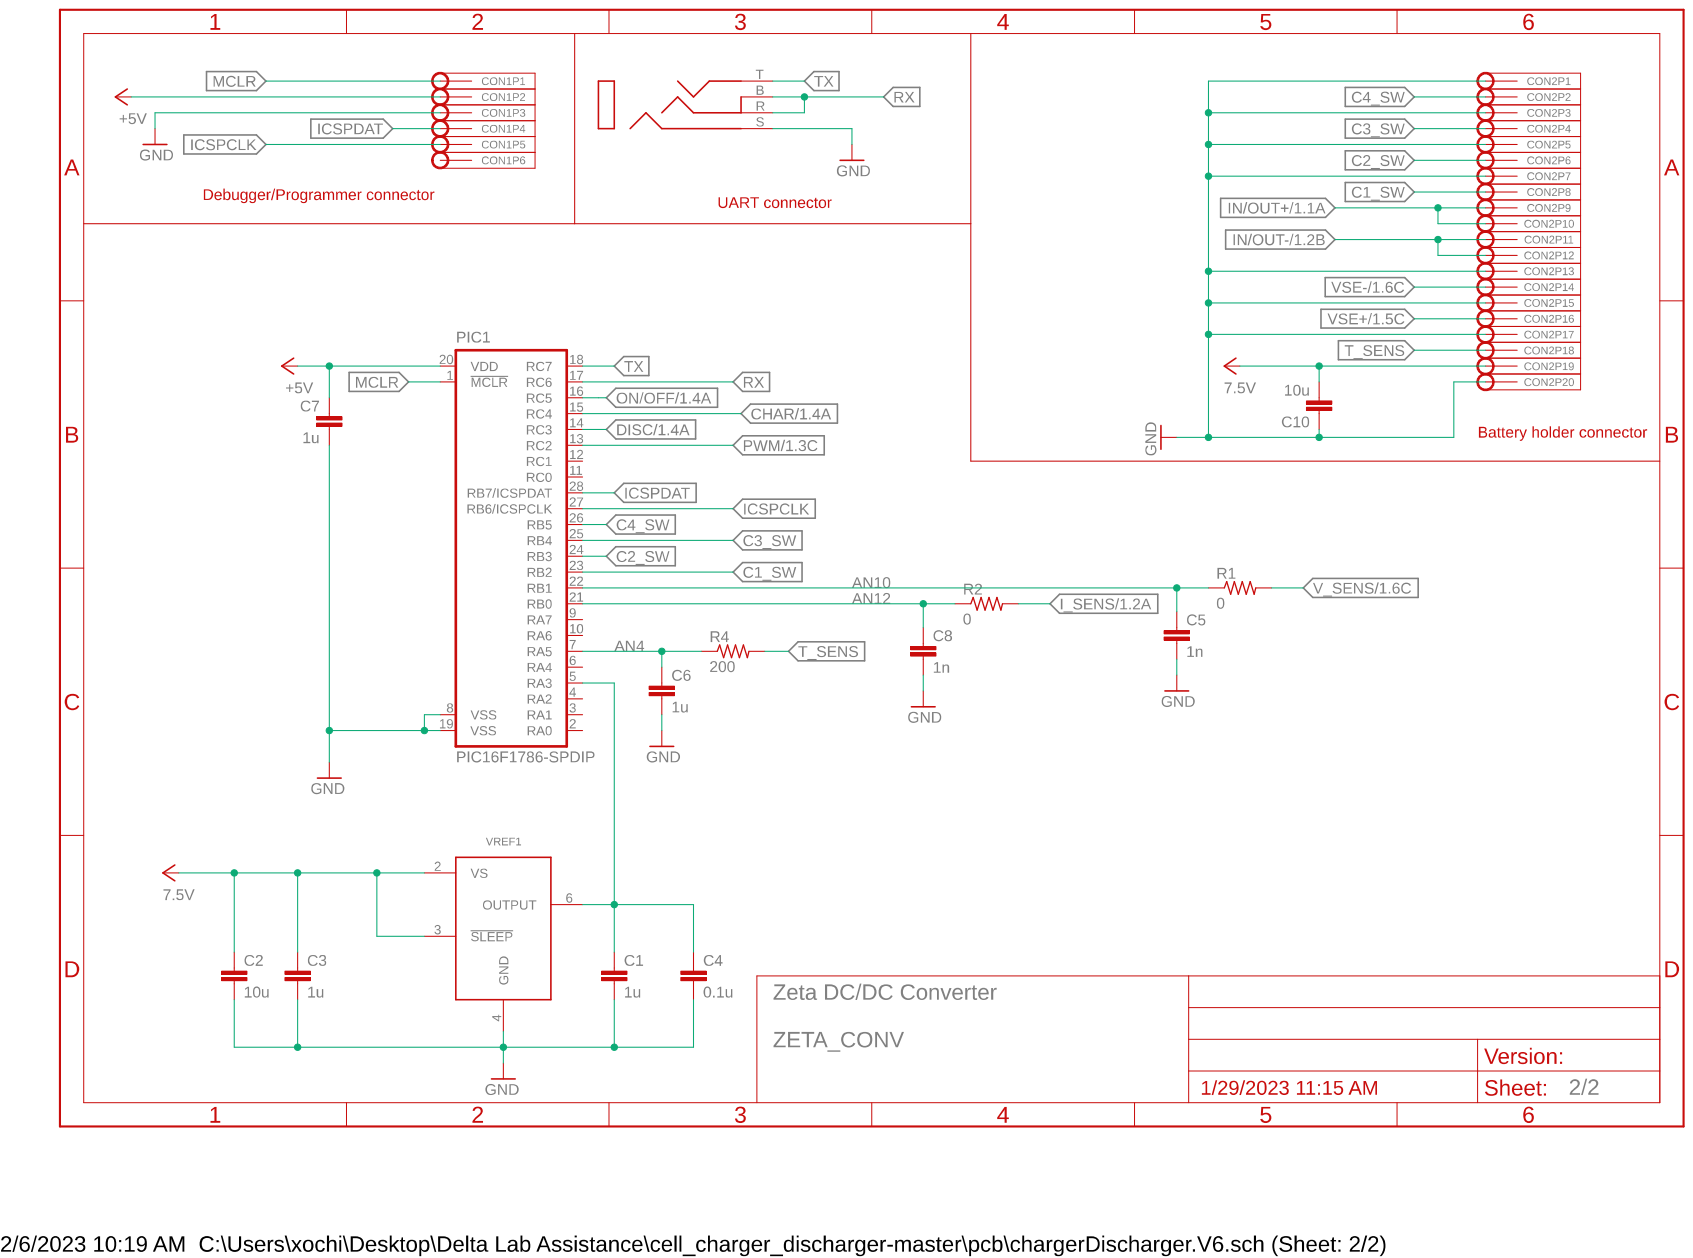
[picture p6: page 2]

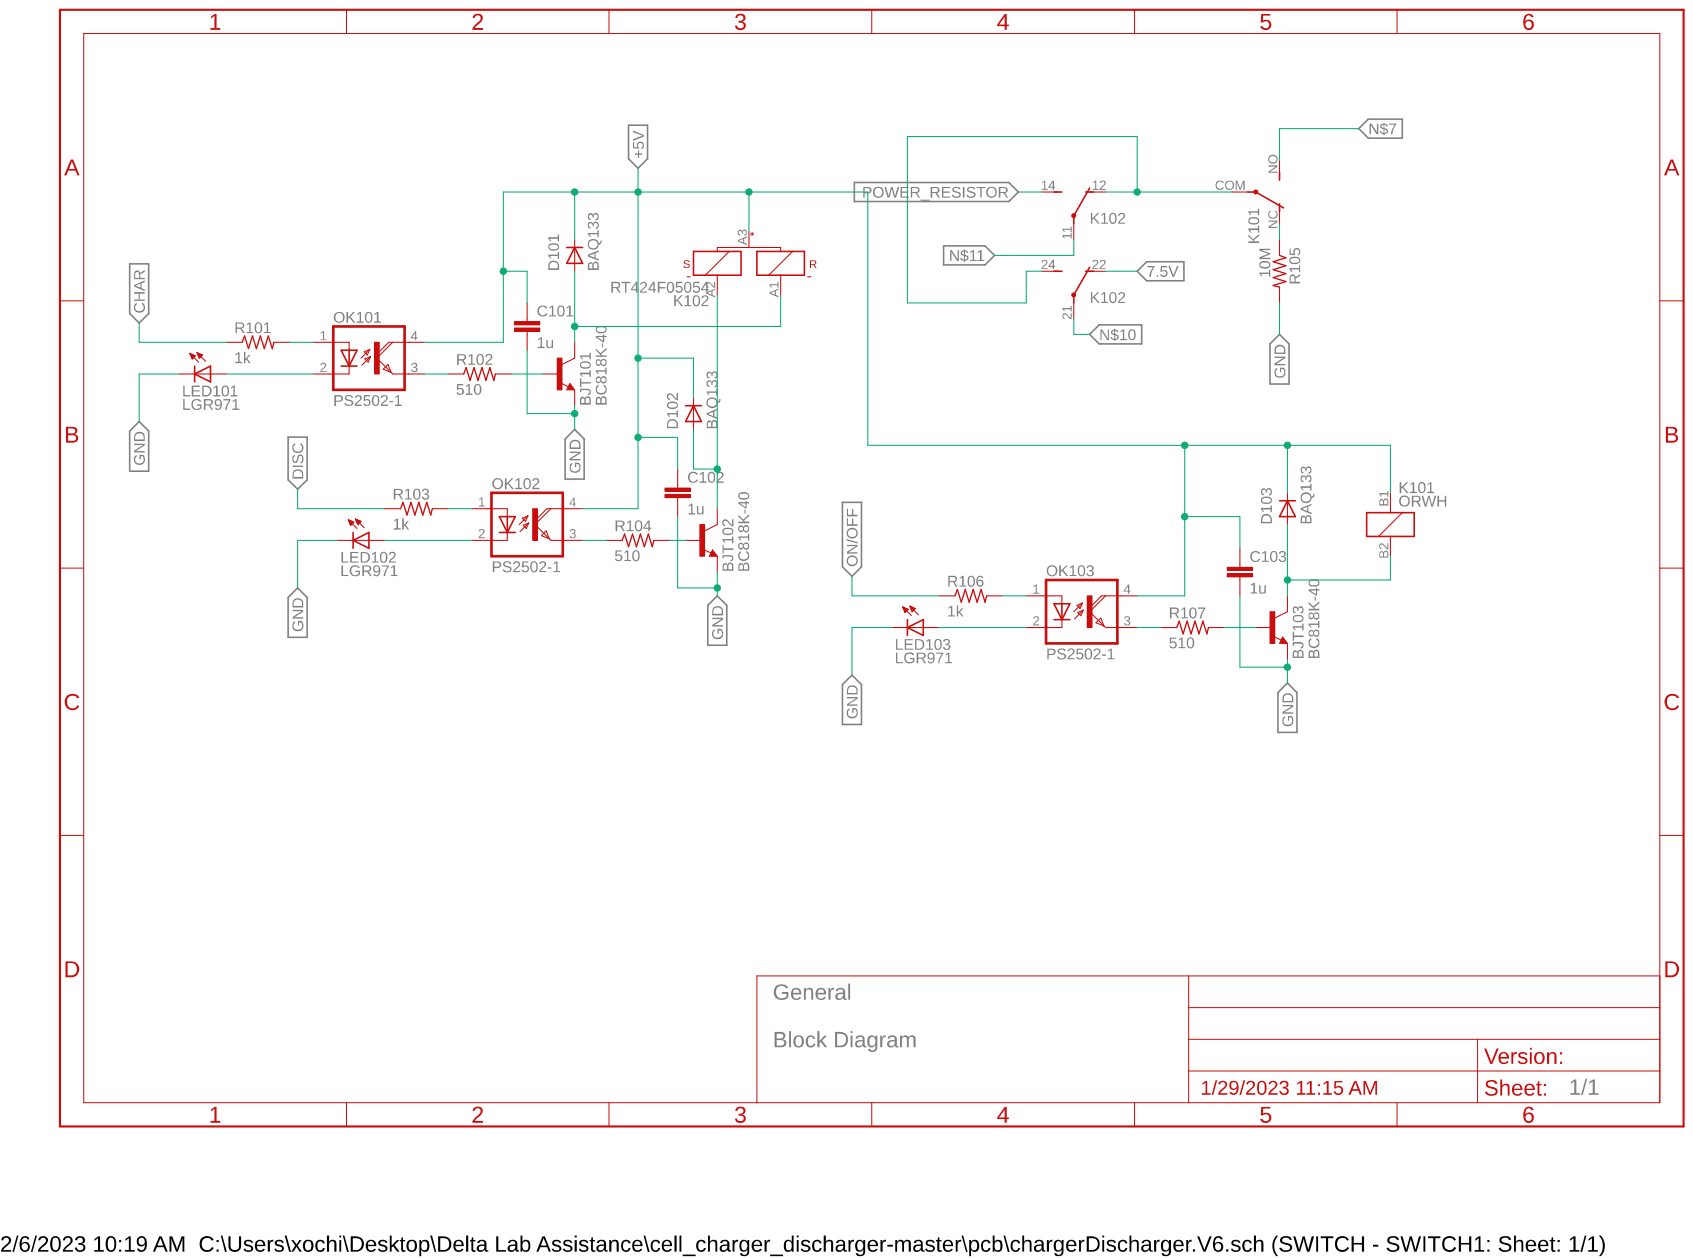
[picture p7: page 3]

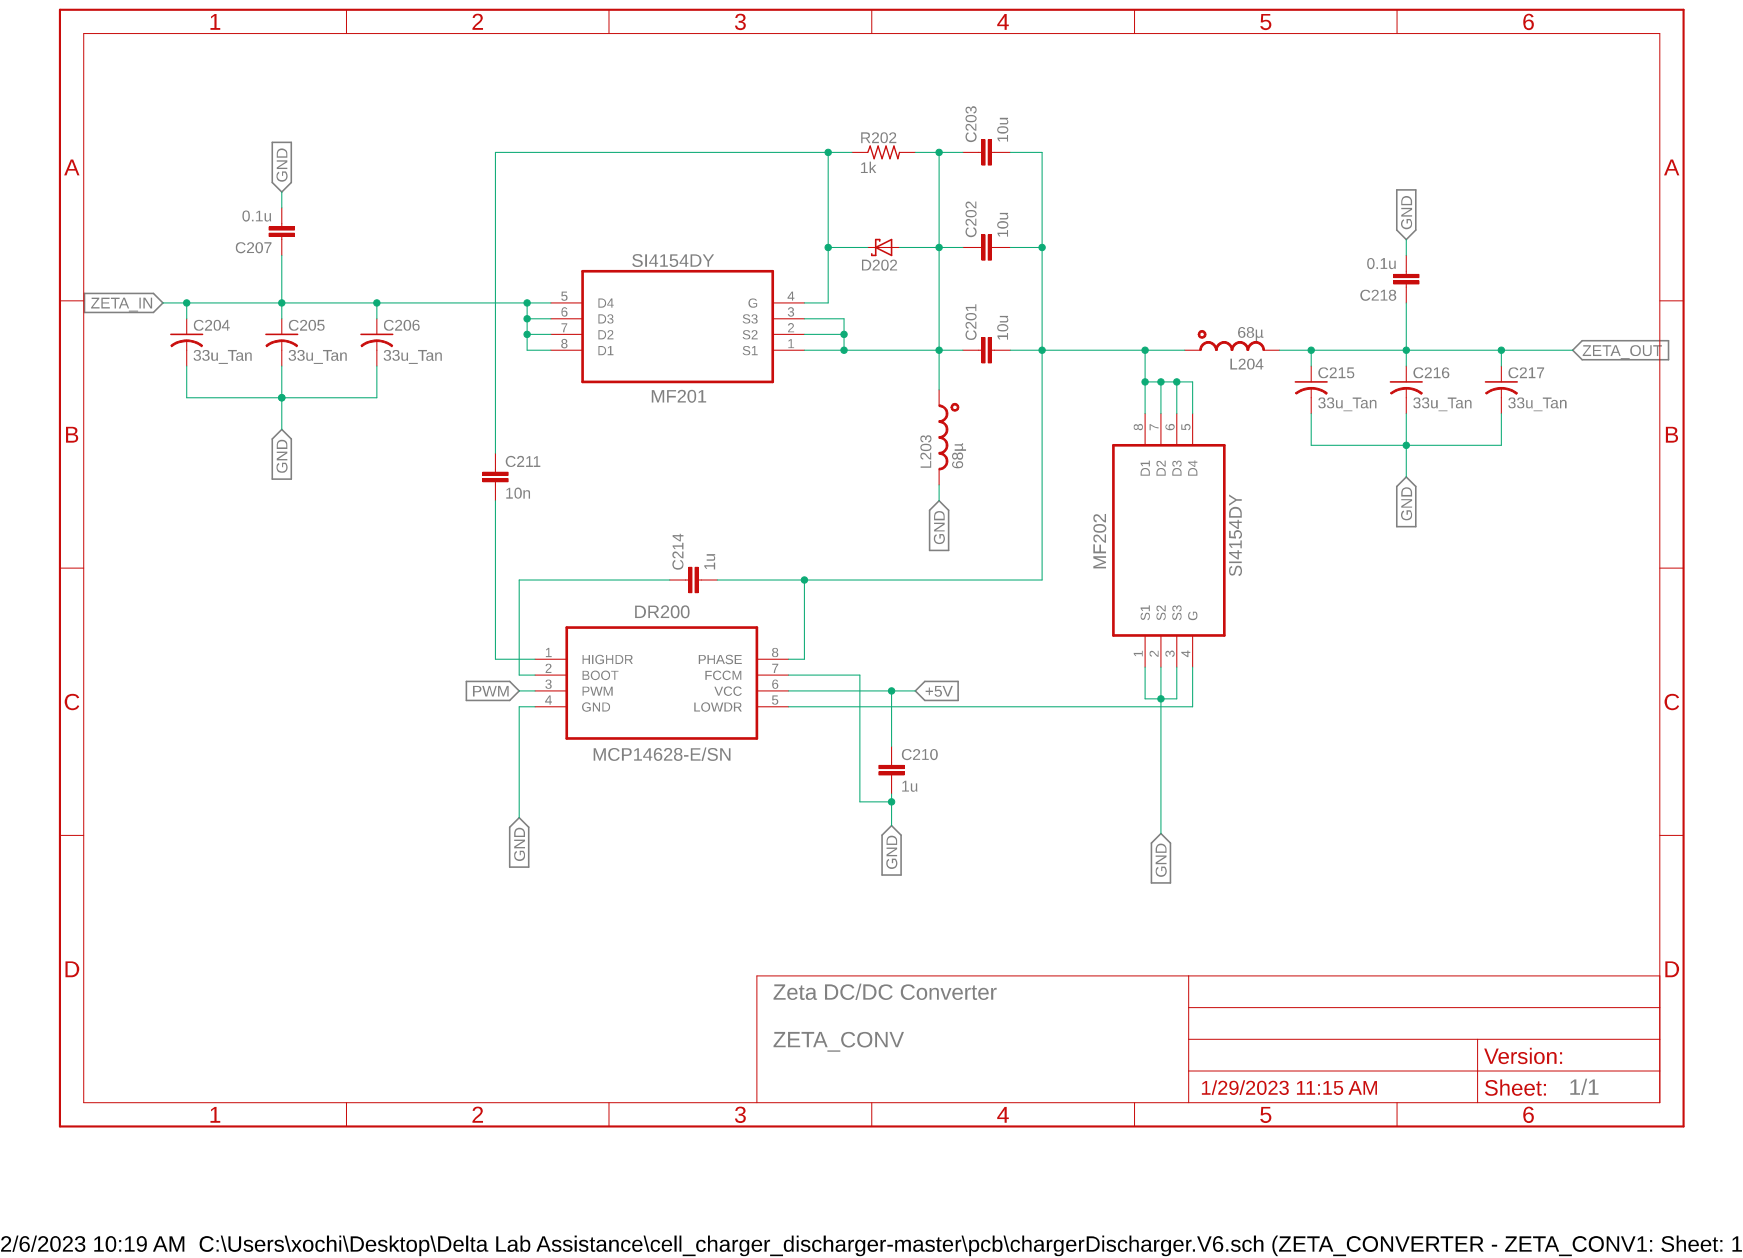
[picture p8: page 4]

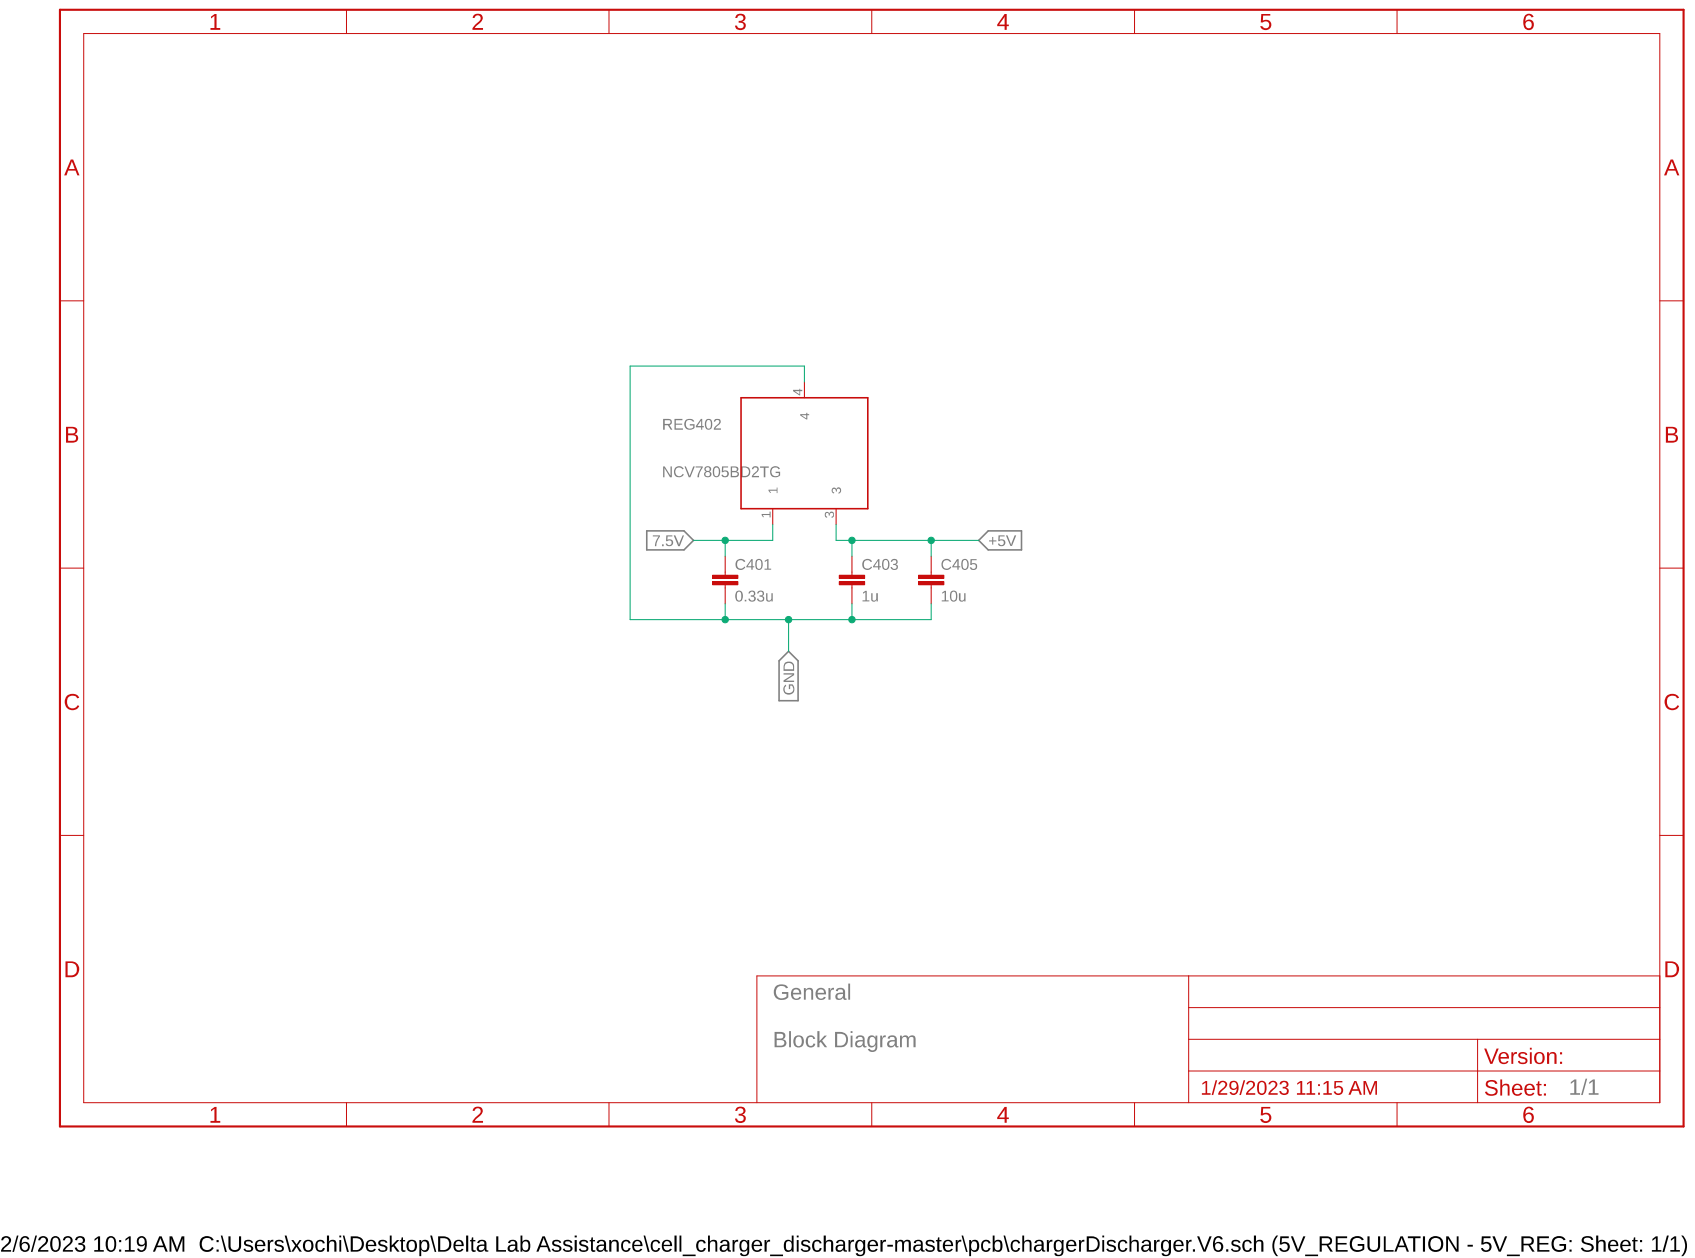
[picture p9: page 5]

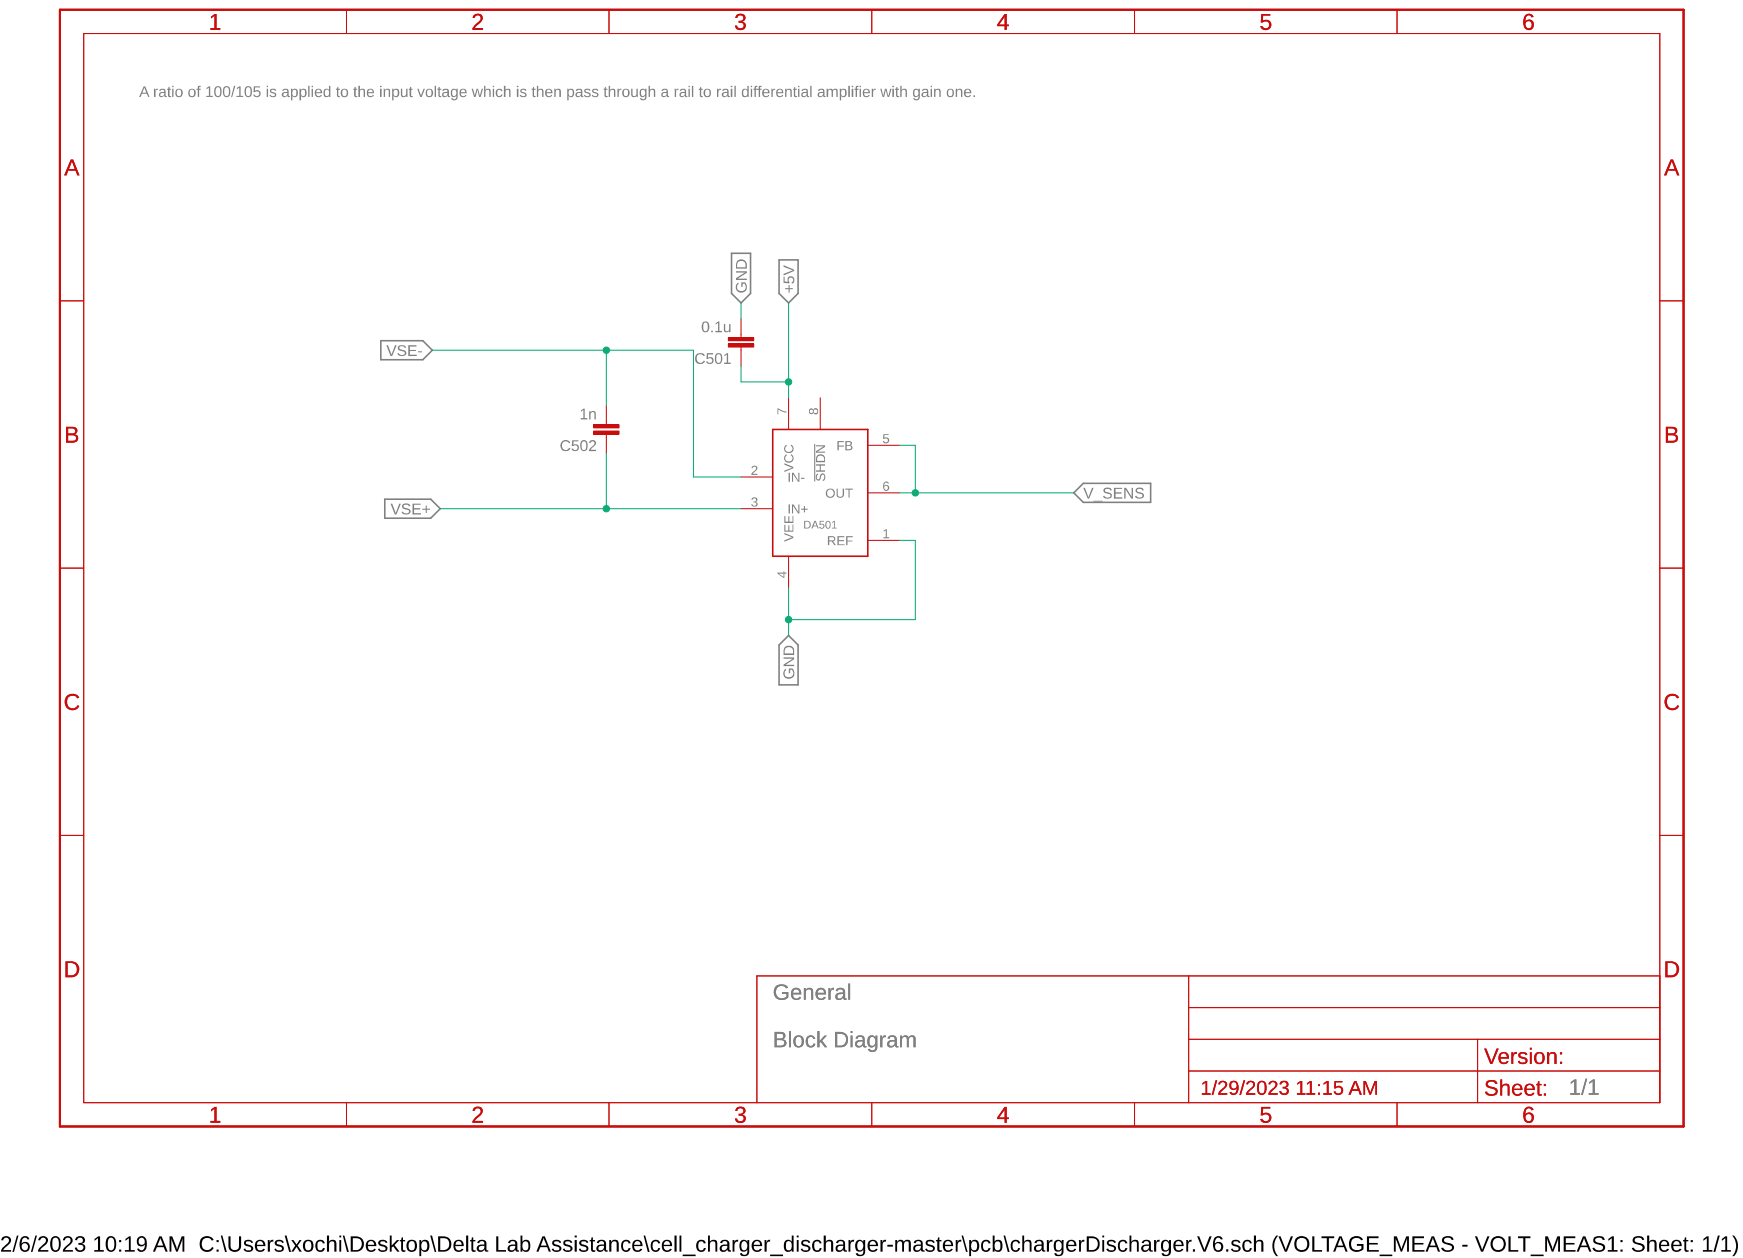
[picture p10: page 6]

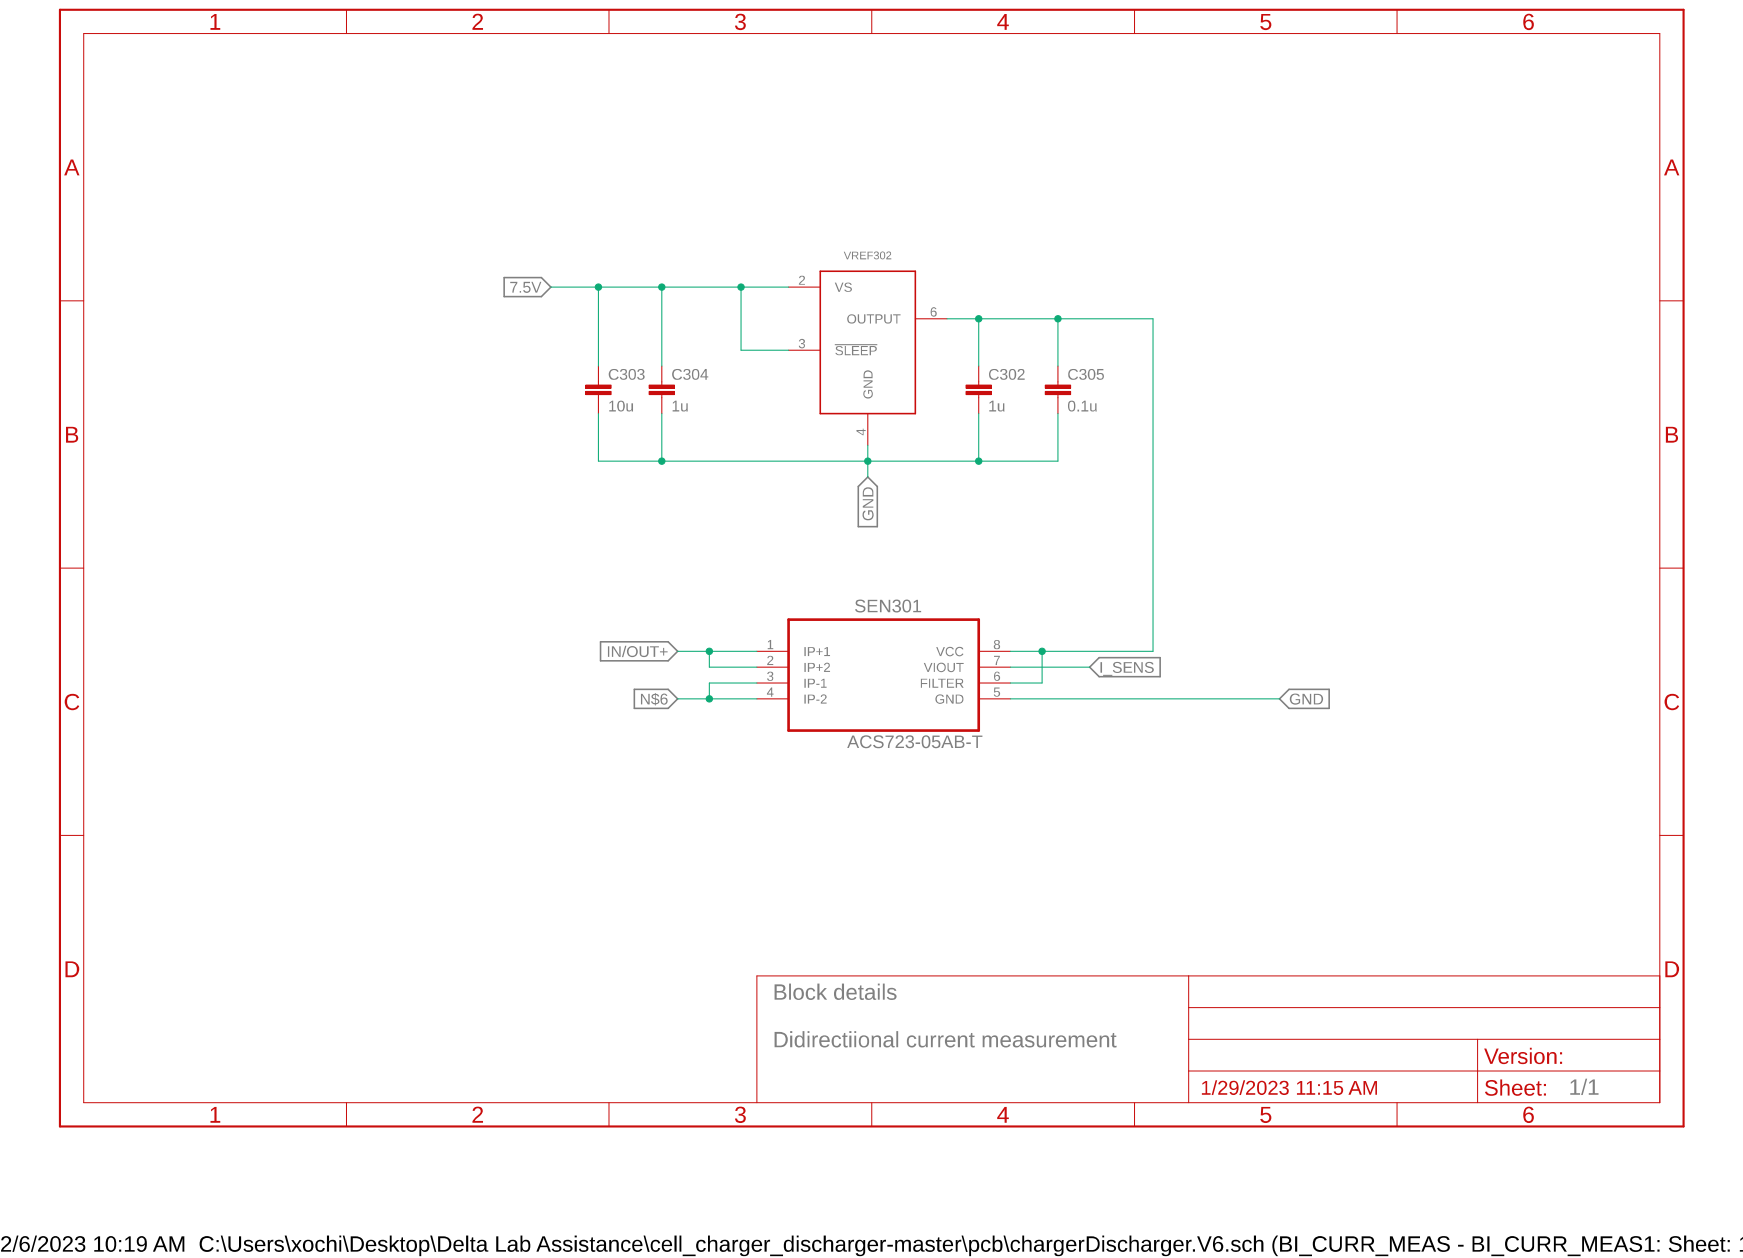
[picture p11: page 7]

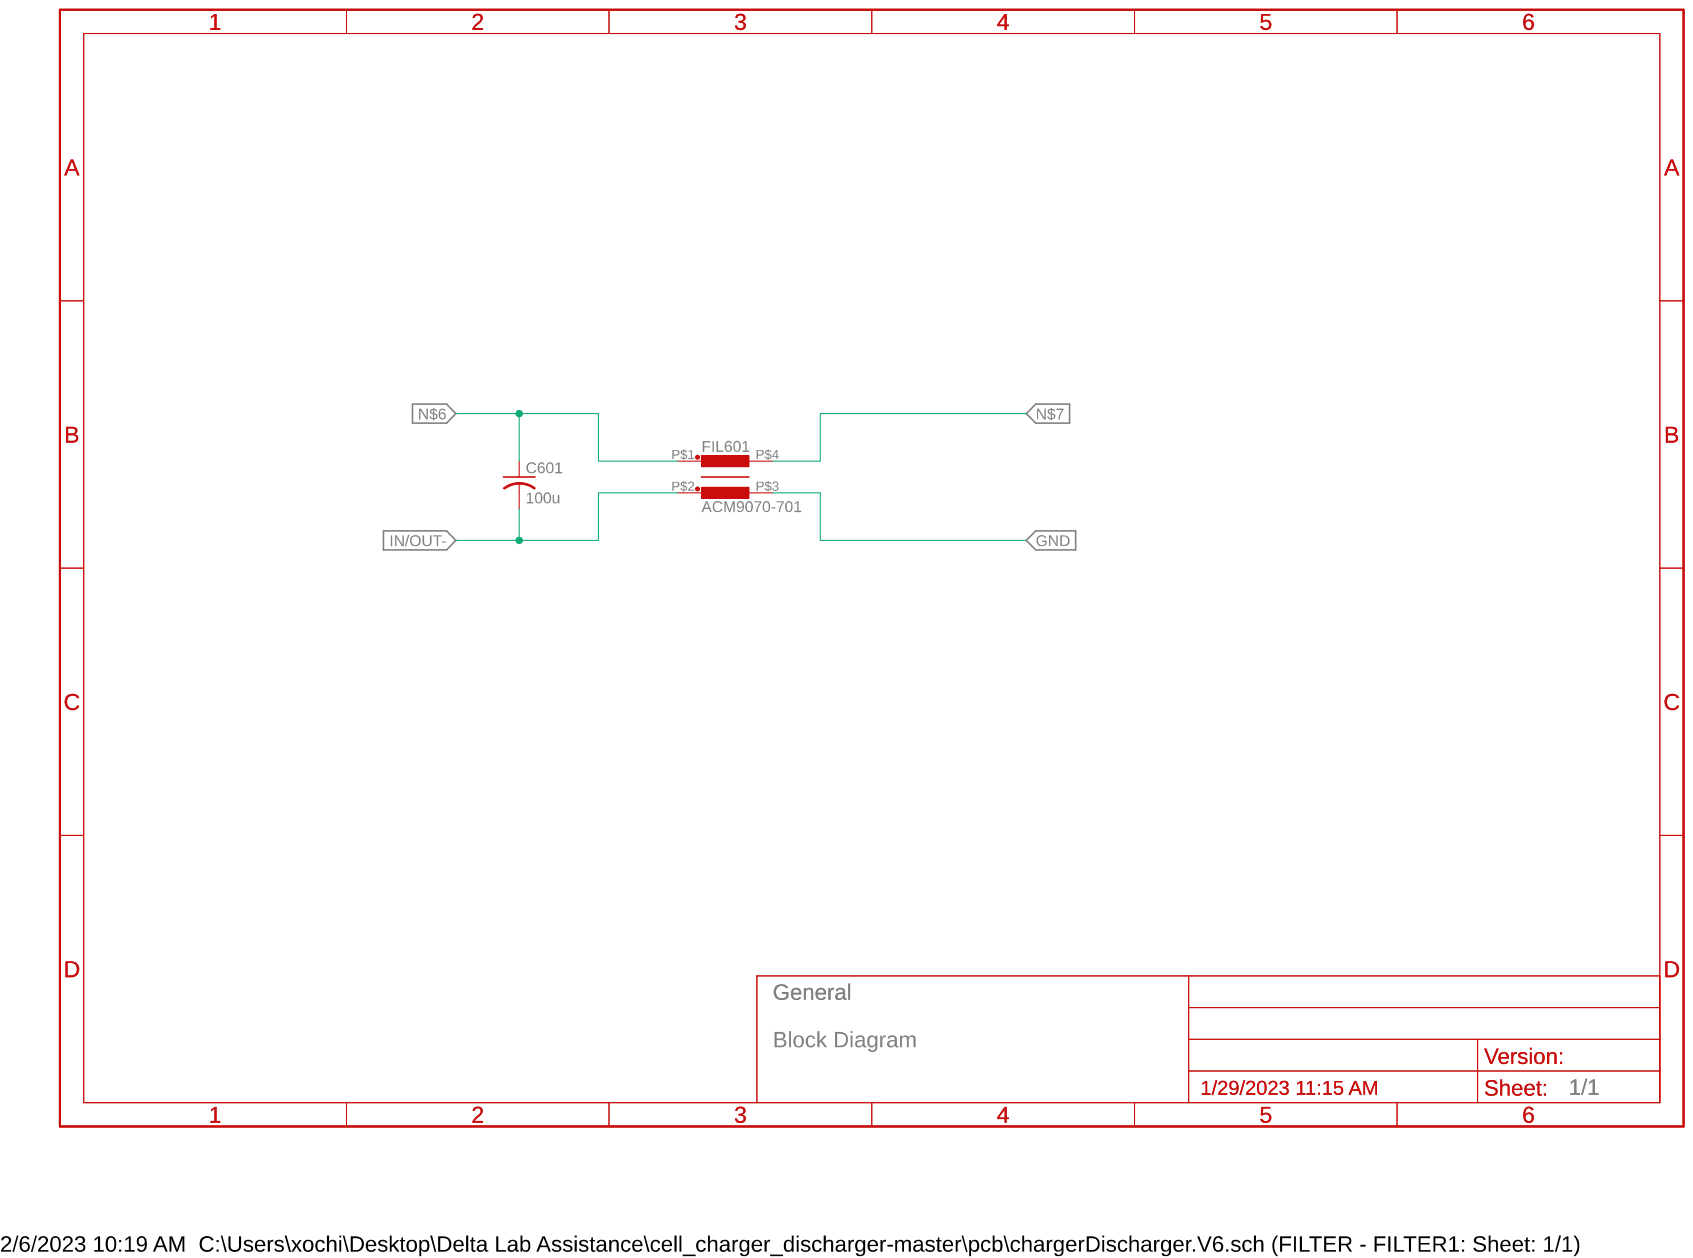
[picture p12: page 8]

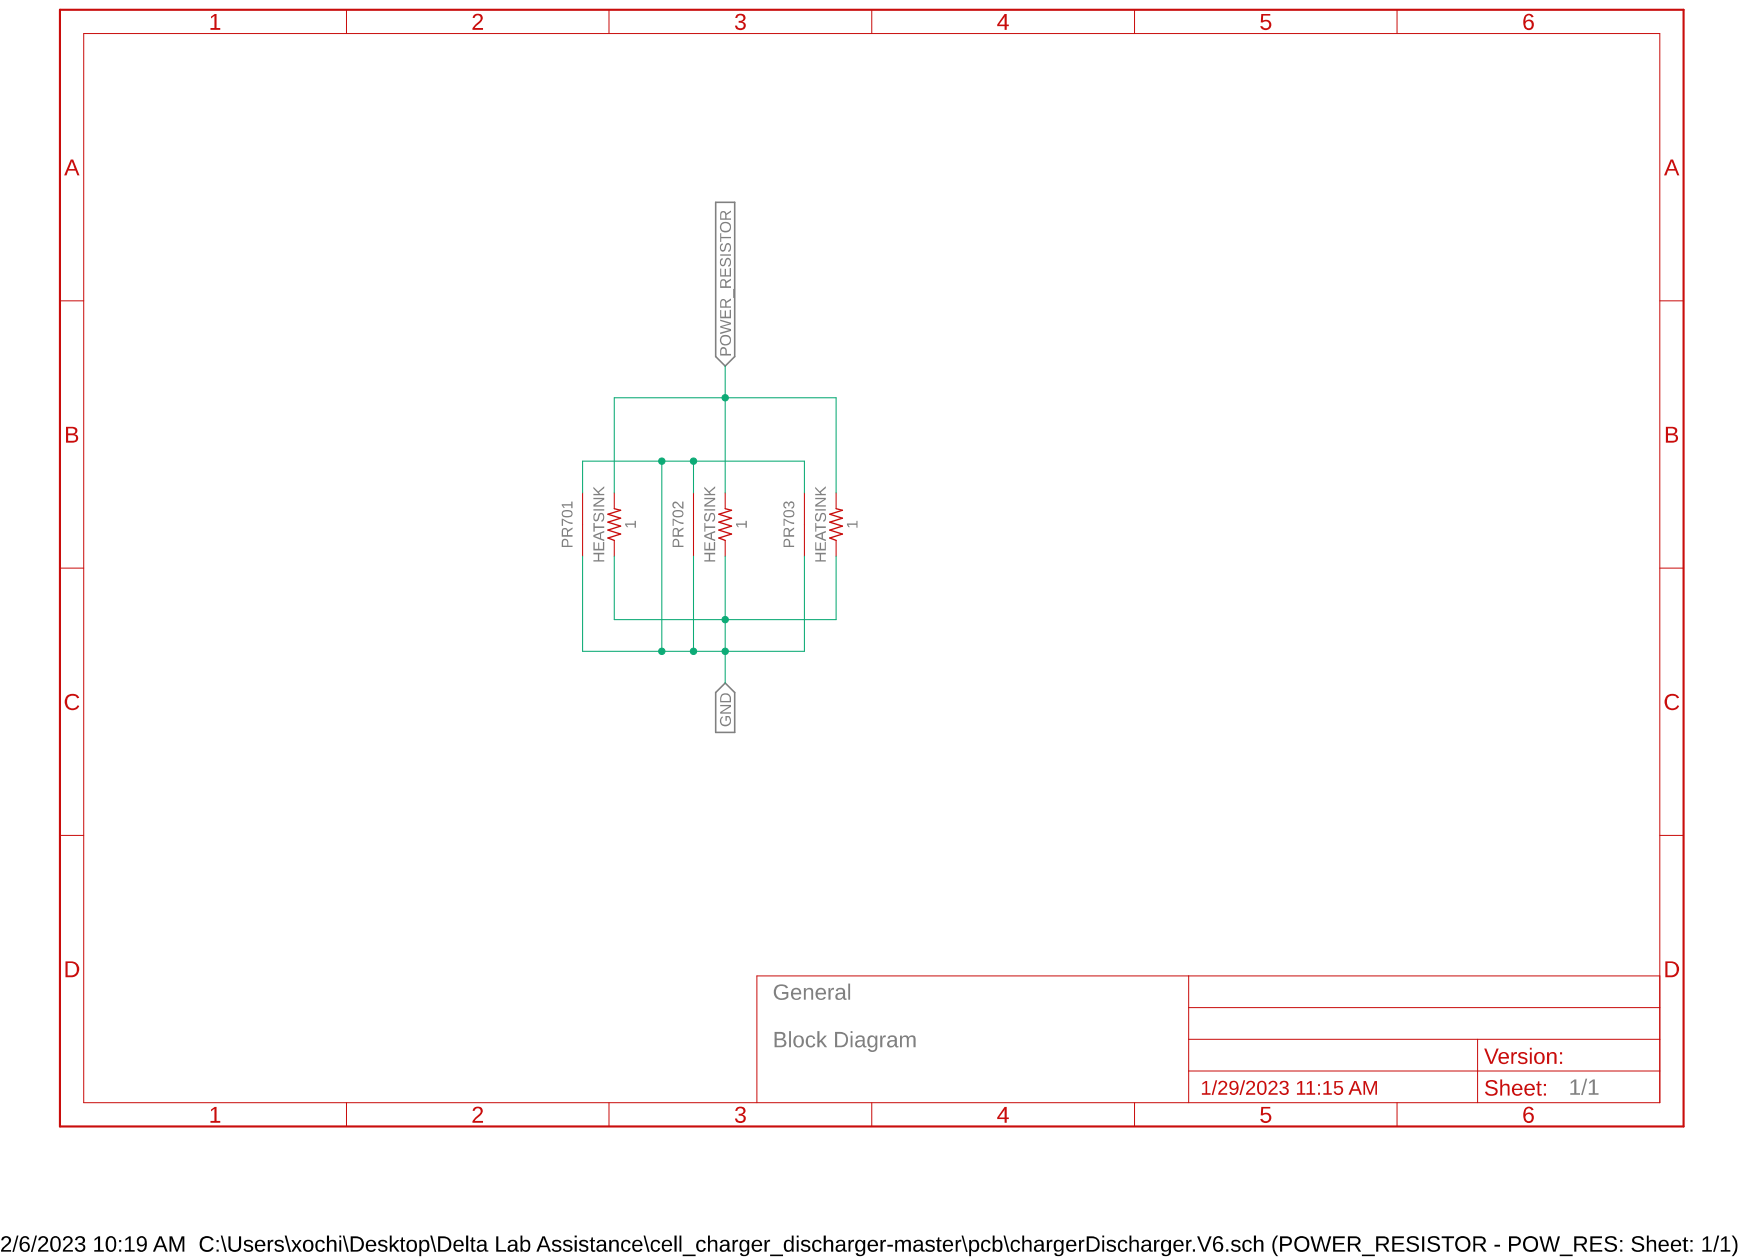
[picture p13: page 9]
