DeltaLabo/cell_charger_discharger/pcb/cellSwitcher_li_ion_V6_schematic.pdf

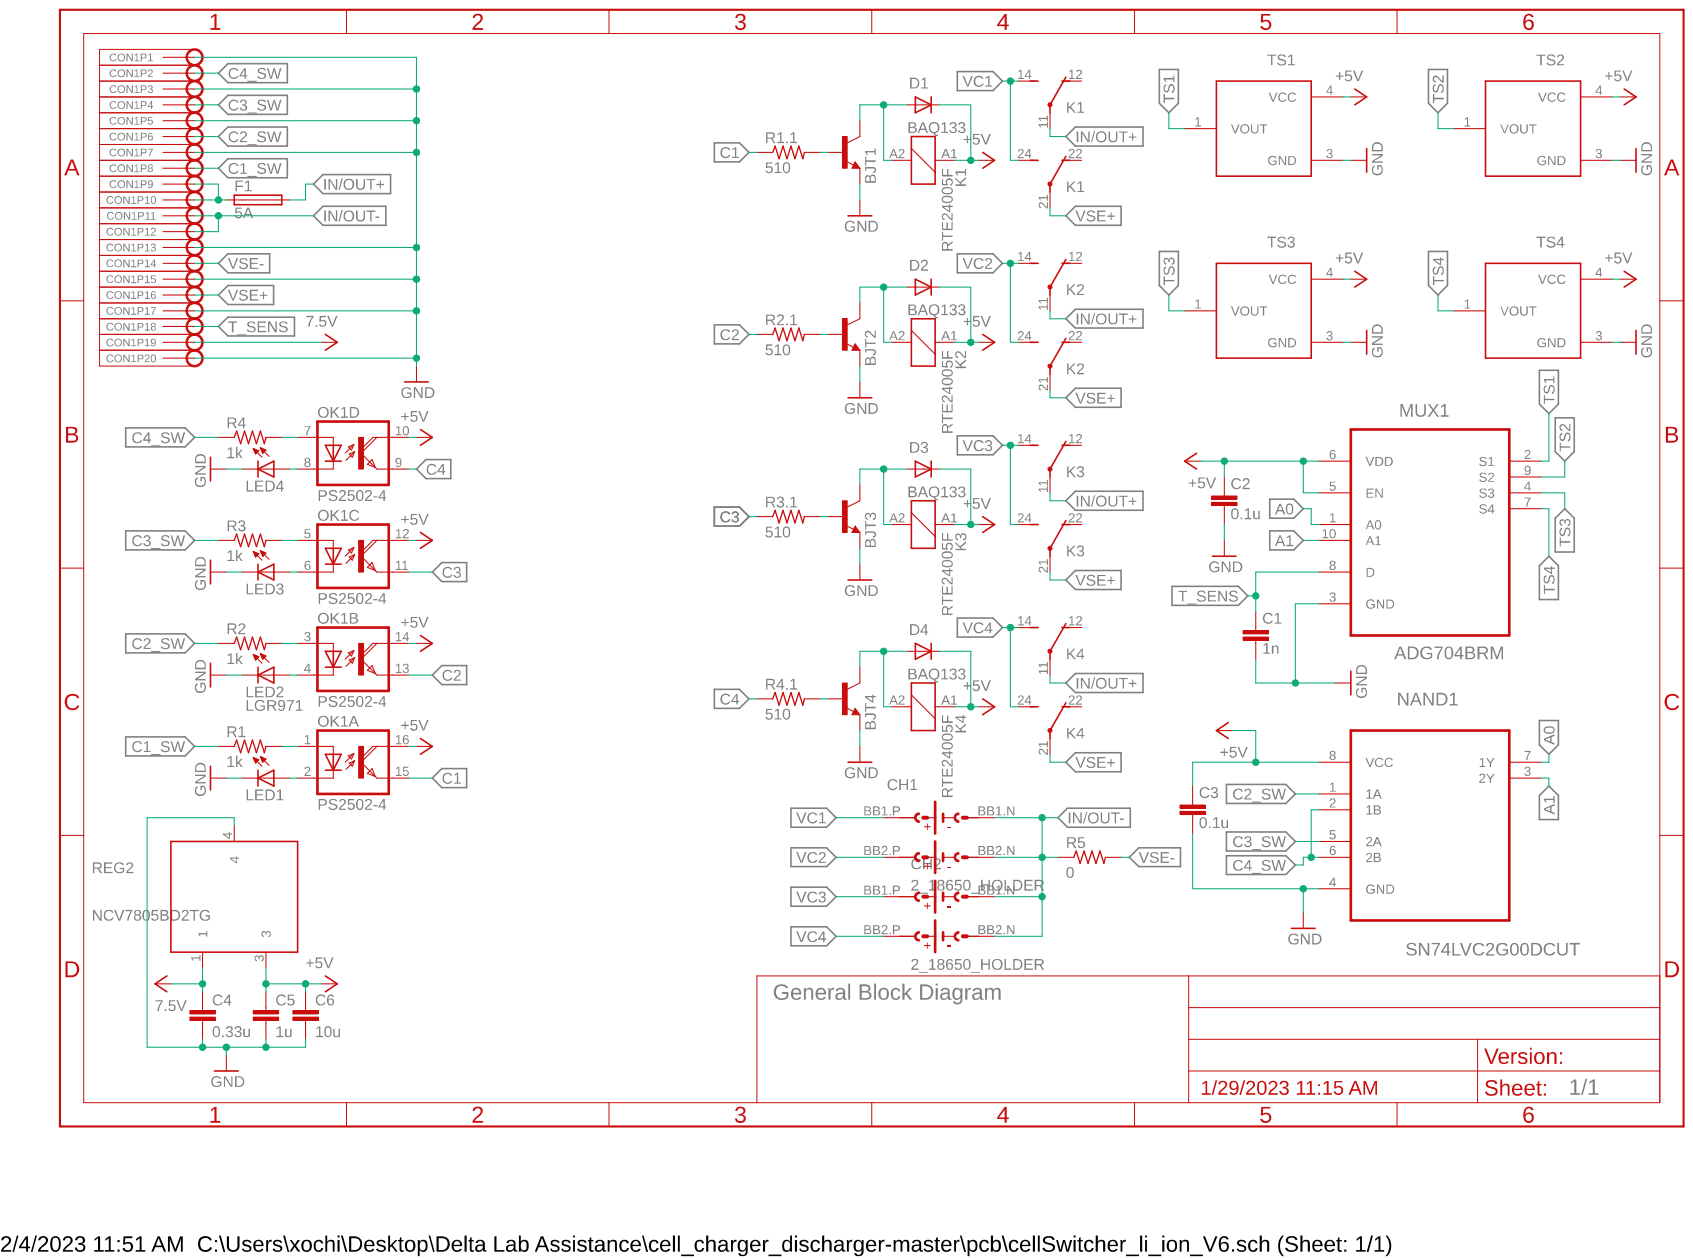
[picture p14: page 1]
