DeltaLabo/cell_charger_discharger/pcb/cellSwitcher_li_ion_V6_board.pdf

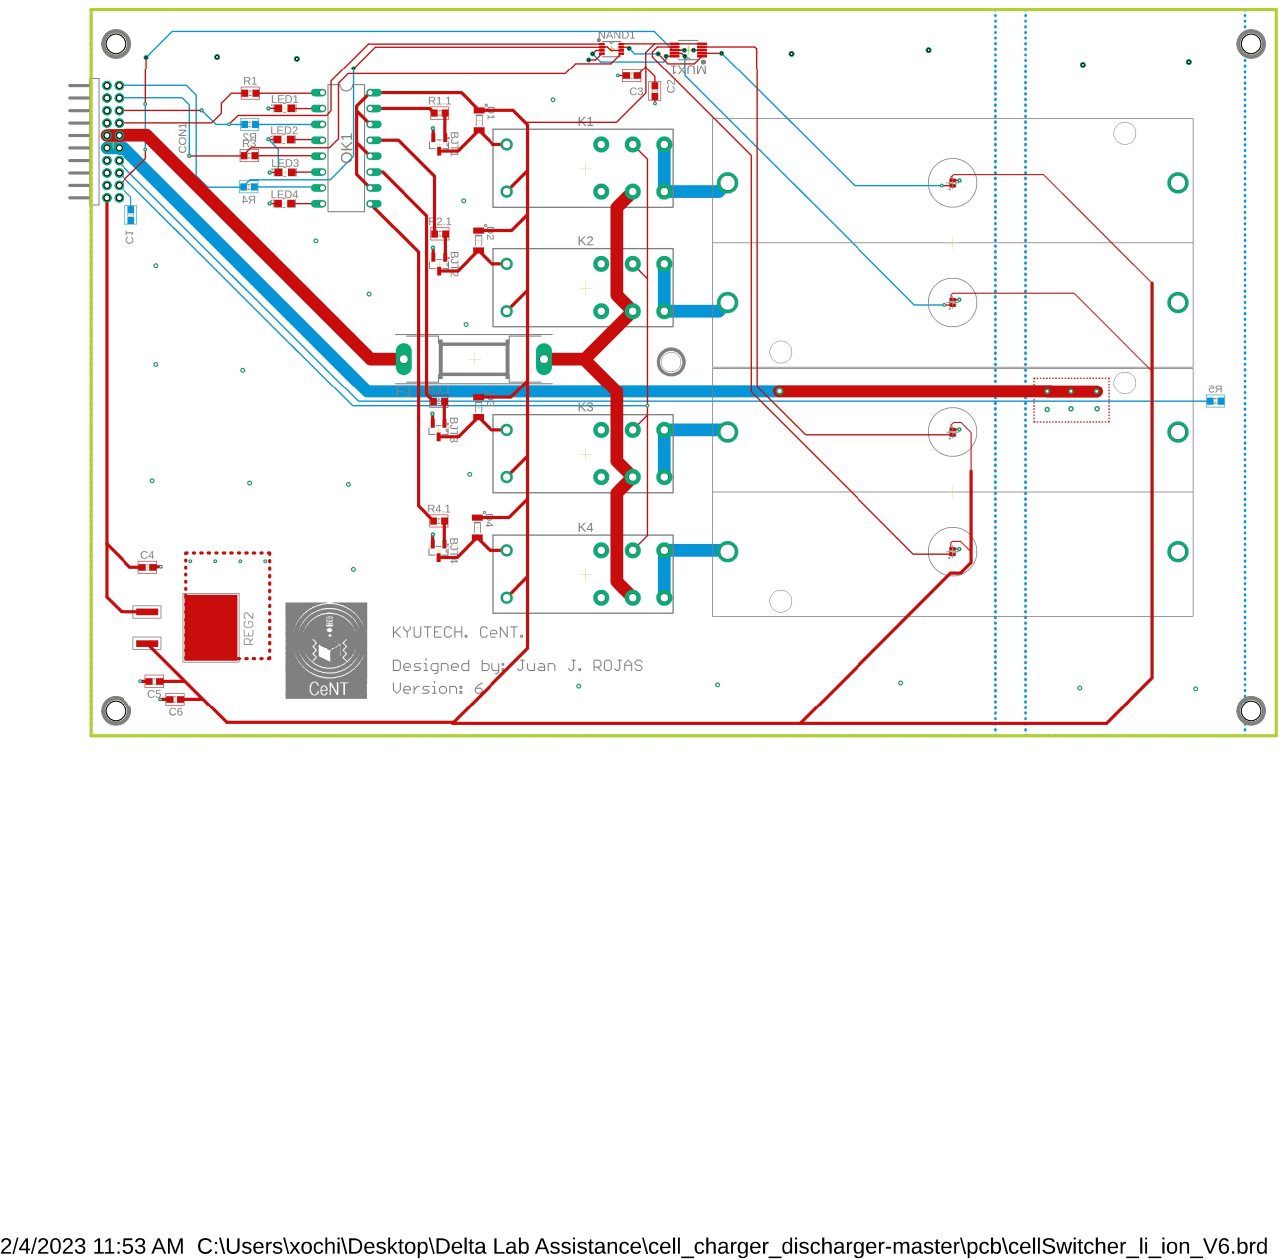
[picture p15: page 1]
