DeltaLabo/cell_charger_discharger/pcb/chargerDischarger.V5.brd

## EAGLE design pcb/chargerDischarger.V5.brd (2019-07-14, an earlier design)

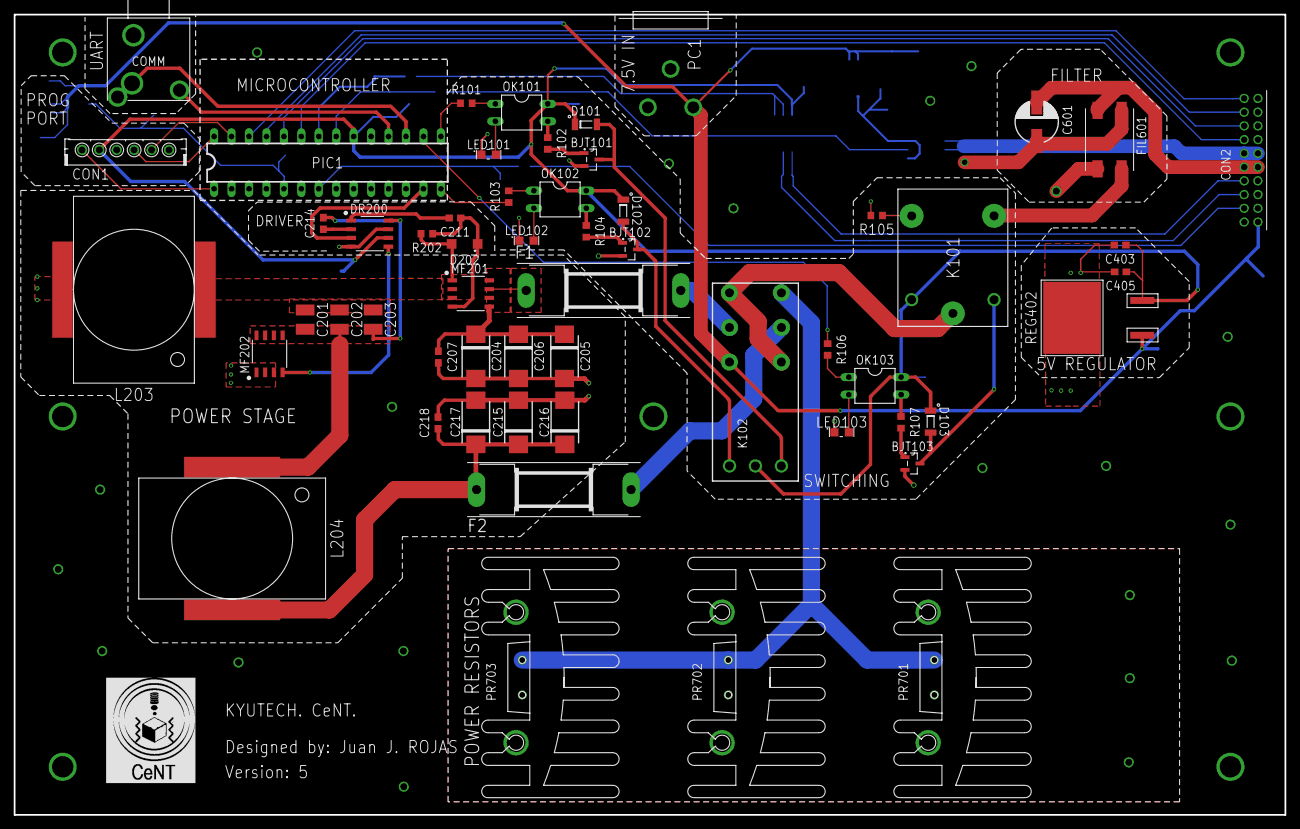
[picture p16: board chargerDischarger.V5.brd from above]

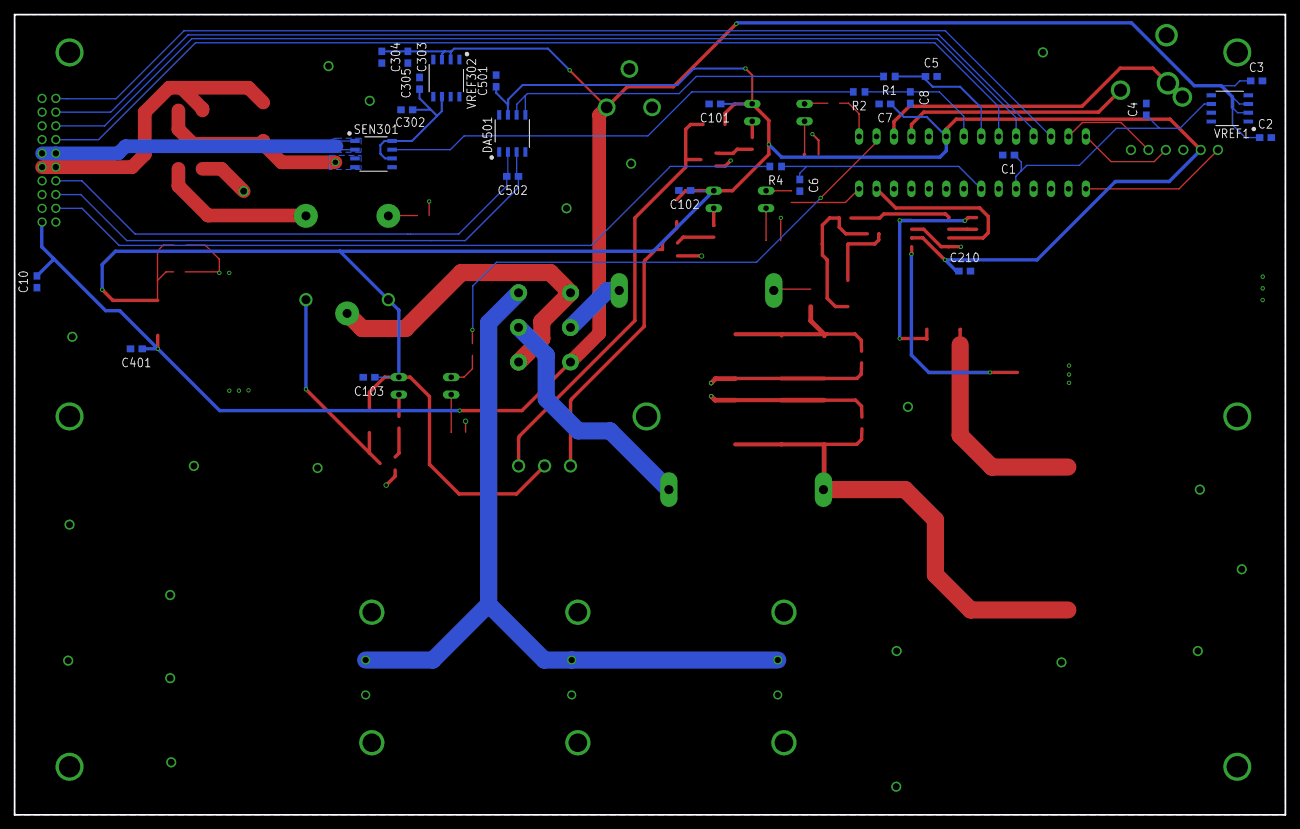
[picture p17: board chargerDischarger.V5.brd from below]

Board: 2 copper layers, 185.0 x 116.5 mm, 83 parts (27 on the bottom side), 58 nets.

Parts:
BJT101, BJT102, BJT103: BC818K-40; SOT-23
C1, C3, C6, C7, C101, C102, C103, C210, C214, C302, C304, C403: 1u; C0603
C2, C10, C303, C405: 10u; C0603
C4, C207, C218, C305, C501: 0.1u; C0603
C5, C8, C502: 1n; C0603
C201, C202, C203: 10u; C1210
C204, C205, C206, C215, C216, C217: 33u_Tan; C7343
C211: 10n; C0603
C401: 0.33u; C0603
C601: 100u; D6.3_AEC
COMM: AUDIO_JACK-3.5MM; KLBR4
CON1: B6B-EH-A
CON2: SQT-110-01-F-D-RA
D101, D102, D103: BAQ133; SOD08
D202: SOD123
DA501: MAX4198; SOIC-8
DR200: MCP14628-E/SN; SOIC-8
F1, F2: 4A; SH22,5
FIL601: ACM9070-701
K101: ORWH; ORWH-SS-105D1F
K102: RT424F05054; RT424F05
L203, L204: 68µ; 60B683C
LED101, LED102, LED103: LGR971; SML0805
MF201, MF202: SI4154DY; SOIC-8
OK101, OK102, OK103: PS2502-1; DIL04
PC1: 722RA
PIC1: PIC16F1786-SPDIP; SPDIP-28
PR701, PR702, PR703: 1; TO-220HEATSINK
R1, R2: 0; R0603
R4: 200; R0603
R101, R103, R106, R202: 1k; R0603
R102, R104, R107: 510; R0603
R105: 10M; R0603
REG402: NCV7805BD2TG; D2PAK-3
SEN301: ACS723-05AB-T; SOIC-8
VREF1, VREF302: REF195GSZ; SOIC-8

Connections:
7.5V: C2.1, C3.1, C10.2, C303.1, C304.1, C401.1, CON2.19, K102.22, PC1.PIN, REG402.1, VREF1.2, VREF1.3, VREF302.2, VREF302.3
+5V: C7.1, C101.1, C102.1, C103.1, C210.1, C403.1, C405.1, C501.1, CON1.2, D101.C, D102.C, D103.C, DA501.7, DR200.6, K101.B1, K102.A3, OK101.4, OK102.4, OK103.4, PIC1.20, REG402.3
BI_CURR_MEAS1:N$1: C302.1, C305.1, SEN301.6, SEN301.8, VREF302.6
C1_SW: CON2.8, PIC1.23
C2_SW: CON2.6, PIC1.24
C3_SW: CON2.4, PIC1.25
C4_SW: CON2.2, PIC1.26
CHAR: PIC1.14, R103.1
DISC: PIC1.15, R101.1
GND: BJT101.2, BJT102.2, BJT103.2, C1.2, C2.2, C3.2, C4.2, C5.2, C6.2, C7.2, C8.2, C10.1, C101.2, C102.2, C103.2, C204.-, C205.-, C206.-, C207.2, C210.2, C215.-, C216.-, C217.-, C218.2, C302.2, C303.2, C304.2, C305.2, C401.2, C403.2, C405.2, C501.2, COMM.S, CON1.3, CON2.1, CON2.3, CON2.5, CON2.7, CON2.13, CON2.15, CON2.17, CON2.20, DA501.1, DA501.4, DR200.4, DR200.7, FIL601.P$3, L203.2, LED101.C, LED102.C, LED103.C, MF202.1, MF202.2, MF202.3, PC1.SLEEVE, PC1.SLEEVE_SHUNT, PIC1.8, PIC1.19, PR701.D1, PR701.D2, PR701.R1, PR702.D1, PR702.D2, PR702.R1, PR703.D1, PR703.D2, PR703.R1, R105.2, REG402.4, SEN301.5, VREF1.4, VREF302.4
ICSPCLK: CON1.5, PIC1.27
ICSPDAT: CON1.4, PIC1.28
IN/OUT+: CON2.9, CON2.10, SEN301.1, SEN301.2
IN/OUT-: C601.NEG, CON2.11, CON2.12, FIL601.P$2
I_SENS: R2.2, SEN301.7
MCLR: CON1.1, PIC1.1
unnamed: C8.1, PIC1.21, R2.1
unnamed: C5.1, PIC1.22, R1.1
unnamed: C6.1, PIC1.7, R4.1
unnamed: C1.1, C4.1, PIC1.5, VREF1.6
unnamed: C601.POS, FIL601.P$1, SEN301.3, SEN301.4
unnamed: FIL601.P$4, K101.NO
unnamed: F1.2, K102.21
unnamed: F2.2, K102.11
ON/OFF: PIC1.16, R106.1
POWER_RESISTOR: K102.14, PR701.R2, PR702.R2, PR703.R2
PWM: DR200.3, PIC1.13
RX: COMM.B, COMM.R, PIC1.17
SWITCH1:N$1: BJT101.1, R102.2
SWITCH1:N$2: BJT101.3, D101.A, K102.A1
SWITCH1:N$3: LED102.A, OK102.2
SWITCH1:N$4: OK102.1, R103.2
SWITCH1:N$5: OK102.3, R104.1
SWITCH1:N$6: BJT102.1, R104.2
SWITCH1:N$7: BJT102.3, D102.A, K102.A2
SWITCH1:N$8: K101.NC, R105.1
SWITCH1:N$9: LED103.A, OK103.2
SWITCH1:N$10: OK103.1, R106.2
SWITCH1:N$11: LED101.A, OK101.2
SWITCH1:N$12: OK101.1, R101.2
SWITCH1:N$13: OK101.3, R102.1
SWITCH1:N$14: OK103.3, R107.1
SWITCH1:N$15: BJT103.1, R107.2
SWITCH1:N$16: BJT103.3, D103.A, K101.B2
SWITCH1:TEST: K101.COM, K102.12, K102.24
TX: COMM.T, PIC1.18
T_SENS: CON2.18, R4.2
VSE+: C502.1, CON2.16, DA501.3
VSE-: C502.2, CON2.14, DA501.2
V_SENS: DA501.5, DA501.6, R1.2
ZETA_CONV1:L1_IN1: C201.1, C202.1, C203.1, D202.A, L203.1, MF201.1, MF201.2, MF201.3, R202.2
ZETA_CONV1:L2_IN1: C201.2, C202.2, C203.2, C214.2, DR200.8, L204.1, MF202.5, MF202.6, MF202.7, MF202.8
ZETA_CONV1:N$10: DR200.5, MF202.4
ZETA_CONV1:N$28: C214.1, DR200.2
ZETA_CONV1:N$29: C211.2, DR200.1
ZETA_CONV1:N$30: C211.1, D202.C, MF201.4, R202.1
ZETA_IN: C204.+, C205.+, C206.+, C207.1, F1.1, MF201.5, MF201.6, MF201.7, MF201.8
ZETA_OUT: C215.+, C216.+, C217.+, C218.1, F2.1, L204.2
