DeltaLabo/cell_charger_discharger/pcb/cellSwitcher_li_ion_V6.brd

## EAGLE design pcb/cellSwitcher_li_ion_V6.brd (2020-10-28)

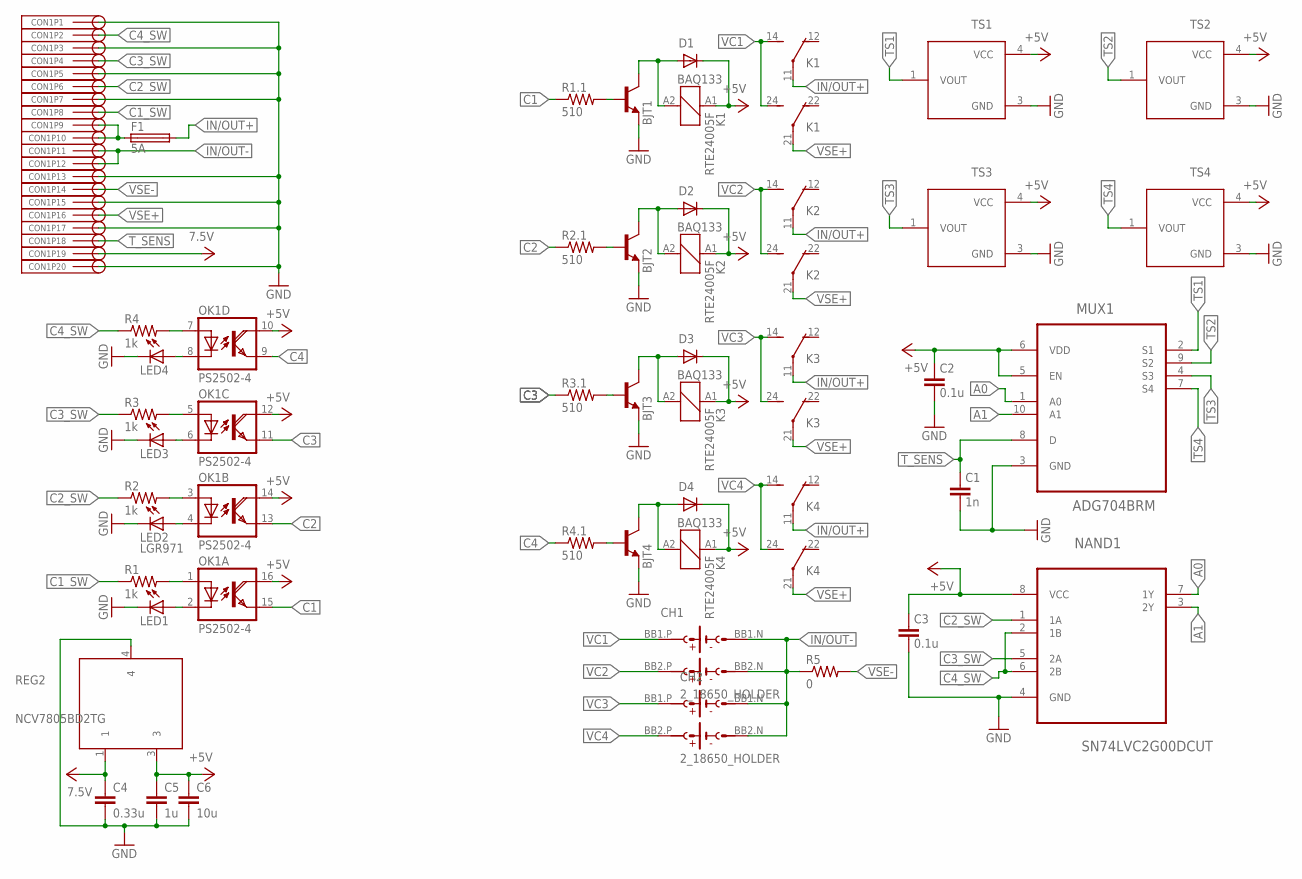
[picture p18: schematic cellSwitcher_li_ion_V6.sch]

Parts:
BJT1, BJT2, BJT3, BJT4: BC818K-40; SOT-23
C1: 1n; C0603
C2, C3: 0.1u; C0603
C4: 0.33u; C0603
C5: 1u; C0603
C6: 10u; C0603
CH1, CH2: 2_18650_HOLDER
CON1: TMM-110-01-F-D-RA
D1, D2, D3, D4: BAQ133; SOD08
F1: 5A; SH22,5
K1, K2, K3, K4: RTE24005F
LED1, LED2, LED3, LED4: LGR971; SML0805
MUX1: ADG704BRM; MSOP10
NAND1: SN74LVC2G00DCUT; VSSOP-8
OK1: PS2502-4; DIL16
R1, R2, R3, R4: 1k; R0603
R1.1, R2.1, R3.1, R4.1: 510; R0603
R5: 0; R0603
REG2: NCV7805BD2TG; D2PAK-3
TS1, TS2, TS3, TS4: STLM20DD9F; UDFN-4L

Connections:
7.5V: C4.1, CON1.19, REG2.1
+5V: C2.1, C3.1, C5.1, C6.1, D1.C, D2.C, D3.C, D4.C, K1.A1 (1), K2.A1 (1), K3.A1 (1), K4.A1 (1), MUX1.5 (EN), MUX1.6 (VDD), NAND1.8 (VCC), OK1.10 (COL), OK1.12 (COL), OK1.14 (COL), OK1.16 (COL), REG2.3, TS1.4 (VCC), TS2.4 (VCC), TS3.4 (VCC), TS4.4 (VCC)
A0: MUX1.1 (A0), NAND1.7 (1Y)
A1: MUX1.10 (A1), NAND1.3 (2Y)
C1: OK1.15 (EMI), R1.1.1
C1_SW: CON1.8, R1.1
C2: OK1.13 (EMI), R2.1.1
C2_SW: CON1.6, NAND1.1 (1A), R2.1
C3: OK1.11 (EMI), R3.1.1
C3_SW: CON1.4, NAND1.5 (2A), R3.1
C4: OK1.9 (EMI), R4.1.1
C4_SW: CON1.2, NAND1.2 (1B), NAND1.6 (2B), R4.1
GND: BJT1.2 (E), BJT2.2 (E), BJT3.2 (E), BJT4.2 (E), C1.2, C2.2, C3.2, C4.2, C5.2, C6.2, CON1.1, CON1.3, CON1.5, CON1.7, CON1.13, CON1.15, CON1.17, CON1.20, LED1.C, LED2.C, LED3.C, LED4.C, MUX1.3 (GND), NAND1.4 (GND), REG2.4, TS1.3 (GND), TS2.3 (GND), TS3.3 (GND), TS4.3 (GND)
IN/OUT+: F1.2, K1.11 (COM), K2.11 (COM), K3.11 (COM), K4.11 (COM)
IN/OUT+1: CON1.9, CON1.10, F1.1
IN/OUT-: CH1.BB1.N (B1.N), CH1.BB2.N (B2.N), CH2.BB1.N (B1.N), CH2.BB2.N (B2.N), CON1.11, CON1.12, R5.1
unnamed: BJT1.1 (B), R1.1.2
unnamed: BJT2.1 (B), R2.1.2
unnamed: BJT3.1 (B), R3.1.2
unnamed: BJT3.3 (C), D3.A, K3.A2 (2)
unnamed: LED1.A, OK1.2 (C)
unnamed: LED2.A, OK1.4 (C)
unnamed: LED3.A, OK1.6 (C)
unnamed: LED4.A, OK1.8 (C)
unnamed: OK1.7 (A), R4.2
unnamed: OK1.5 (A), R3.2
unnamed: OK1.3 (A), R2.2
unnamed: OK1.1 (A), R1.2
unnamed: BJT1.3 (C), D1.A, K1.A2 (2)
unnamed: BJT2.3 (C), D2.A, K2.A2 (2)
unnamed: BJT4.1 (B), R4.1.2
unnamed: BJT4.3 (C), D4.A, K4.A2 (2)
TS1: MUX1.2 (S1), TS1.1 (VOUT)
TS2: MUX1.9 (S2), TS2.1 (VOUT)
TS3: MUX1.4 (S3), TS3.1 (VOUT)
TS4: MUX1.7 (S4), TS4.1 (VOUT)
T_SENS: C1.1, CON1.18, MUX1.8 (D)
VC1: CH1.BB1.P (B1.P), K1.14 (NO), K1.24 (NO)
VC2: CH1.BB2.P (B2.P), K2.14 (NO), K2.24 (NO)
VC3: CH2.BB1.P (B1.P), K3.14 (NO), K3.24 (NO)
VC4: CH2.BB2.P (B2.P), K4.14 (NO), K4.24 (NO)
VSE+: CON1.16, K1.21 (COM), K2.21 (COM), K3.21 (COM), K4.21 (COM)
VSE-: CON1.14, R5.2

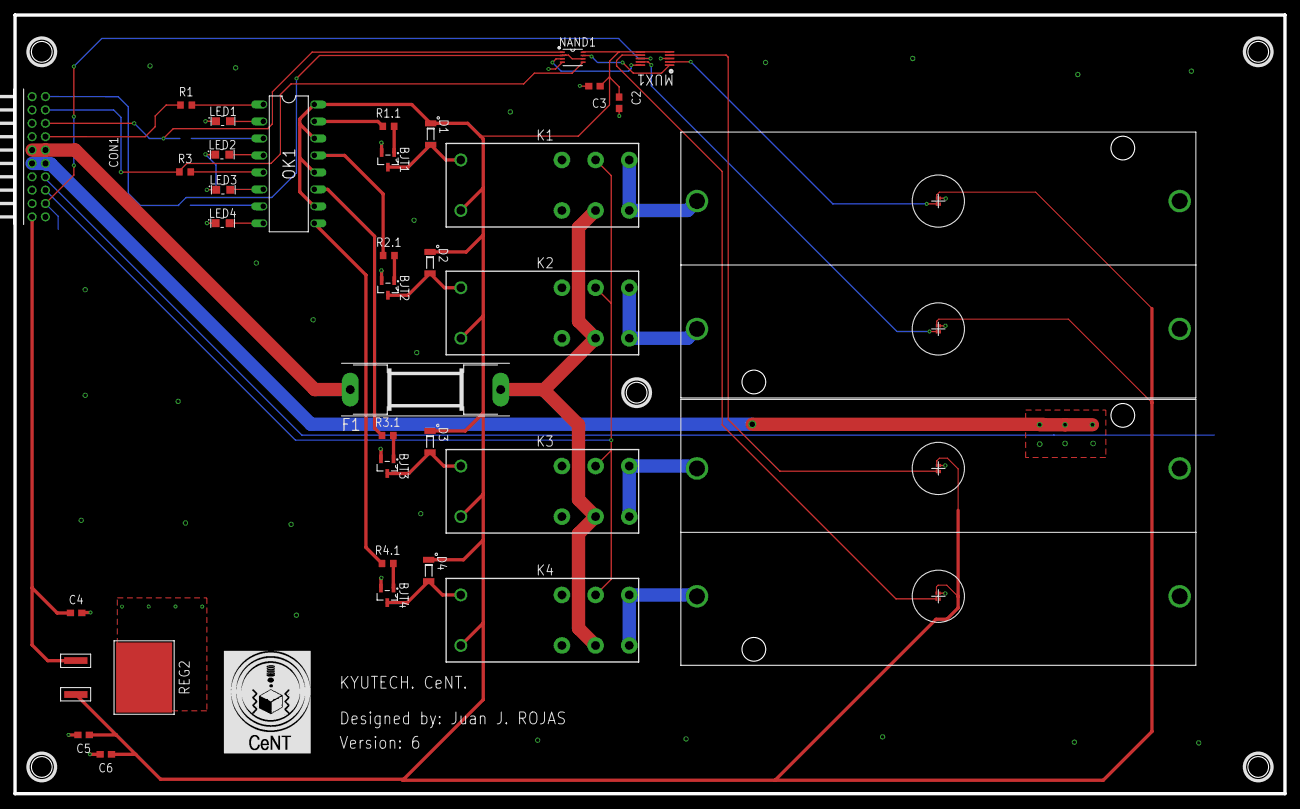
[picture p19: board cellSwitcher_li_ion_V6.brd from above]

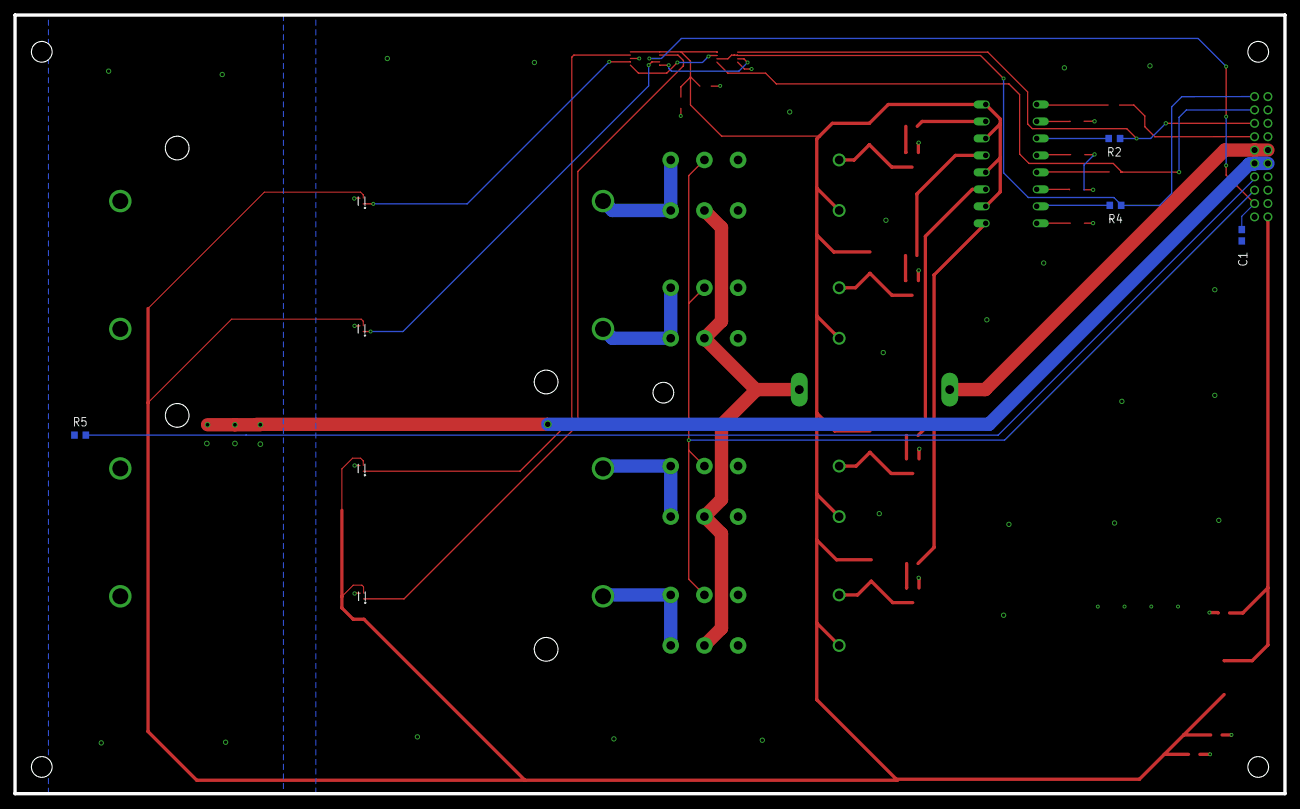
[picture p20: board cellSwitcher_li_ion_V6.brd from below]

Board: 2 copper layers, 190.0 x 116.5 mm, 43 parts (4 on the bottom side), 43 nets.
