DeltaLabo/cell_charger_discharger/hardware.c

/**
 * @file hardware.c
 * @author Juan J. Rojas
 * @date 7 Aug 2018
 * @brief Hardware source file for Charge and Discharge System.
 * @par Institution:
 * LaSEINE / CeNT. Kyushu Institute of Technology.
 * @par Mail (after leaving Kyutech):
 * juan.rojas@tec.ac.cr
 * @par Git repository:
 * https://bitbucket.org/juanjorojash/cell_charger_discharger
 */

#include "hardware.h"
#include "state_machine.h"

/**@brief Function to define initialize the system
*/
void Initialize()
{
    /** @b GENERAL*/
    nWPUEN = 0; /// * Allow change of individual WPU
    /** @b SYSTEM @b CLOCK*/
    /** PLL is always enabled because of configuration bits*/
    OSCCONbits.IRCF = 0b1111; /// * Set clock to 32MHz (with PLL)
    OSCCONbits.SCS = 0b00; /// * Clock determined by FOSC<2:0> in Configuration Words
    OSCCONbits.SPLLEN = 1; /// * Enable PLL. According to Errata this shall not be done in the Configuration Words
    /** @b RELAY @b OUPUTS*/
    TRISA0 = 0; /// * Set RA0 as output. Charge/Discharge relay
    ANSA0 = 0; /// * Set RA0 as digital
    TRISA1 = 0; /// * Set RA3 as output. ON/OFF relay
    ANSA1 = 0; /// * Set RA3 as digital
    /** @b CELL @b SWITCHER @b OUPUTS*/
//    TRISA7 = 0; /// * Set RA7 as output. Cell #1
//    ANSA7 = 0; /// * Set RA7 as digital
//    TRISA6 = 0; /// * Set RA6 as output. Cell #2
//    ANSA6 = 0; /// * Set RA6 as digital   //DOES NOT EXIST
//    TRISC0 = 0; /// * Set RC0 as output. Cell #3
//    ANSC0 = 0; /// * Set RC0 as digital  //DOES NOT EXIST
//    TRISC1 = 0; /// * Set RC1 as output. Cell #4
//    ANSC1 = 0; /// * Set RC1 as digital  //DOES NOT EXIST
    /** @b TIMER0 for control and measuring loop*/
    TMR0IE = 0; /// * Disable timer interruptions
    TMR0CS = 0; /// * Timer set to internal instruction cycle
    OPTION_REGbits.PS = 0b110; /// * Prescaler set to 128
    OPTION_REGbits.PSA = 0; /// * Prescaler activated
    TMR0IF = 0; /// * Timer flag cleared
    TMR0 = 0x07; /// * Counter set to 255 - @b 250 + 2 (delay for sync) = 7
    /** Timer set to 32Mhz/4/128/250 = 250Hz*/
    /** @b PSMC/PWM @b SETTINGS*/
    /** Outputs*/
    TRISA4 = 1; /// * [Temporary] Set RA4 as input to let it drive from RB3.
    WPUA4 = 0; /// * [Temporary] Disable WPU for RA4.
    WPUC0 = 0; /// * [Temporary] Disable WPU for RC0.
    /** Programmable switch mode control (PSMC)*/
    PSMC1CON = 0x00; /// * Clear PSMC1 configuration to start
    PSMC1MDL = 0x00; /// * No modulation
    PSMC1CLK = 0x01; /// * Driven by 64MHz PLL system clock
    PSMC1PRH = 0x01; /// * Set period high register to 0x01
    PSMC1PRL = 0xFF; /// * Set period low register to 0xFF
    /** 511 + 1 clock cycles for period that is 8us (125KHz)*/
    /** This set the PWM with 9 bit of resolution*/
    /** Duty cycle*/
    PSMC1DCH = 0x00;                    // * Set duty cycle high register to 0x00   
    PSMC1DCL = 0x00;                    // * Set duty cycle low register to 0x00
    /* Duty cycle starts in 0 */  
    /** Phase or rising event*/
    PSMC1PHH = 0x00;                    /// * Rising event starts from the beginning
    PSMC1PHL = 0x00;                    /// * Rising event starts from the beginning
    PSMC1STR0bits.P1STRA = 1;           /// * Single PWM activated in PSMC1A (RCO))
    PSMC1POLbits.P1POLA = 0;            /// * Active high
    PSMC1OENbits.P1OEA = 1;             /// * PSMC1A activated in PSMC1A (RC0)
    PSMC1PRSbits.P1PRST = 1;            /// * Period event occurs when PSMC1TMR = PSMC1PR
    PSMC1PHSbits.P1PHST = 1;            /// * Rising edge event occurs when PSMC1TMR = PSMC1PH
    PSMC1DCSbits.P1DCST = 1;            /// * Falling edge event occurs when PSMC1TMR = PSMC1DC
    PSMC1CON = 0x80;                    /// * Enable|Load Buffer|Dead band disabled|Single PWM
    //PSMC1TIE = 1;                       //Enable interrupts for Time Based 
    TRISC0 = 0;                         /// * Set RC0 as output
    /** @b ADC*/
    /** ADC INPUTS*///check this after final design
    TRISA3 = 1; /// * RA3, Positive voltage reference
    ANSA3 = 0; /// * RA3 analog
    WPUA3 = 0; /// * Weak pull up Deactivated
    TRISB4 = 1; /// * RB4, current sensing input
    ANSB4 = 1; /// * RB4 analog
    WPUB4 = 0; /// * Weak pull up Deactivated
    TRISB5 = 1; /// * RB5, voltage sensing input
    ANSB5 = 1; /// * RB5 analog
    WPUB5 = 0; /// * Weak pull up Deactivated
    /** Configs*/
    ADCON0bits.ADRMD = 0; /// * 12 bits result
    ADCON1bits.ADCS = 0b010; /// * Clock selected as FOSC/32
    ADCON1bits.ADNREF = 0; /// * Connected to Vss
    ADCON1bits.ADPREF = 0b00; /// * Connected to VDD, change after to Connected to Vref+ (01)
    ADCON1bits.ADFM = 1; /// * 2's compliment result
    ADCON2bits.CHSN = 0b1111; /// * Negative differential input as ADNREF
    ADCON0bits.ADON = 1; /// * Turn on the ADC
    /** @b UART*/
    //**Setting I/O pins for UART*/
    TXSEL = 0;      /// * RC6 selected as TX
    RXSEL = 0;      /// * RC7 selected as RX
    //________I/O pins set __________//
    
    /**Initialize SPBRG register for required 
    baud rate and set BRGH for fast baud_rate**/
    SP1BRGH = 0x00; 
    SP1BRGL = 0x8A;    
    
    BRGH  = 1;  /// * for high baud_rate
    BRG16 = 1;  /// * for 16 bits timer
    //_________End of baud_rate setting_________//
    
    //****Enable Asynchronous serial port*******//
    SYNC  = 0;    /// * Asynchronous
    SPEN  = 1;    /// * Enable serial port pins
    //_____Asynchronous serial port enabled_______//

    //**Lets prepare for transmission & reception**//
    TXEN  = 1;    /// * enable transmission
    CREN  = 1;    /// * enable reception
    //__UART module up and ready for transmission and reception__//
    
    //**Select 8-bit mode**//  
    TX9   = 0;    /// * 8-bit reception selected
    RX9   = 0;    /// * 8-bit reception mode selected
    //__8-bit mode selected__//    
    /** @b INTERRUPTS*/
    PEIE = 1; /// * Activate pehierals Interrupts
    GIE = 1; /// * Activate Global Interrupts
    RCIE = 0; /// * Disable UART reception interrupts
    TXIE = 0; /// * Disable UART transmision interrupts
    /** @bFINAL CHECK ALL!!*/
    CLRWDT(); /// * Clear WDT by calling @p CLRWDT()
    STOP_CONVERTER(); ///* Call #STOP_CONVERTER()
    TMR0IF = 0; /// * Clear Timer0 flag
    ad_res = 0; /// * Clear ADC result variable
    cmode = 1; /// * Start in CC mode    
    wait_count = 0; /// * CHECK!!!
    dc_res_count = 0; /// * CHECK!!
}
/**@brief This function defines the PI controller
*  @param   feedback average of measured values for the control variable
*  @param   setpoint desire controlled output for the variable
*/
void pid(float feedback, unsigned setpoint)
{ 
float 	er; /// * Define @p er for calculating the error
float   pi; /// * Define @p pi for storing the PI compesator value
    er = setpoint - feedback; /// * Calculate the error by substracting the @p feedback from the @p setpoint and store it in @p er
    if(er > ERR_MAX) er = ERR_MAX; /// * Make sure error is never above #ERR_MAX
    if(er < ERR_MIN) er = ERR_MIN; /// * Make sure error is never below #ERR_MIN
/**Then the proportional and integral component will be calculated.*/
    proportional = (kp * er); /// * Calculate #proportional component of compensator
	integral += (ki * er)/COUNTER; /// * Calculate #integral component of compensator 
	pi = proportional + integral; /// * Sum them up and store in @p pi*/
/**After, the function wil define the duty cycle, and make sure that is never below #DC_MIN or above #DC_MAX */
    if (dc + pi >= DC_MAX){ /// * Make sure duty cycle is never above #DC_MAX
        dc = DC_MAX;
    }else if (dc + pi <= DC_MIN){ /// * Make sure duty cycle is never below #DC_MIN
        dc = DC_MIN;
    }else{
        dc += (int)(pi + 0.5); /// * Store the new value of the duty cycle with operation @code dc = dc + pi @endcode
    }   
}
/**@brief This function sets the desired duty cycle
*/
void set_DC()
{
/// This function can set the duty cycle from 0x0 to 0x1FF. 
    PSMC1DCL = dc & 0x00FF; /// * Lower 8 bits of #dc are stored in @p PSMC1DCL
    PSMC1DCH = (dc >> 8) & 0x01; /// * Higher 1 bit of #dc are stored in @p PSMC1DCH
    PSMC1CONbits.PSMC1LD = 1; /// * Set the load register. This will load all the setting as once*/
}
/**@brief This function switches between CC and CV mode.
* @param current_voltage average of current voltage
* @param referece_voltage voltage setpoint
* @param CC_mode_status current condition of #cmode variable
*/
void cc_cv_mode(float current_voltage, unsigned int reference_voltage, char CC_mode_status)
{
/// If the current voltage is bigger than the voltage setpoint and the system is in CC mode, then:
    if(current_voltage > reference_voltage && CC_mode_status == 1)
    {        
            proportional = 0; /// * The #proportional is set to zero
            integral = 0; /// * The #integral is set to zero
            cmode = 0; /// * The system is set in CV mode by clearing the #cmode variable
            kp = CV_kp; /// * The proportional constant, #kp is set to #CV_kp 
            ki = CV_ki; /// * The integral constant, #ki is set to #CV_ki 
    }     
}
/**@brief This function takes care of printing the test data using the UART
*/
void log_control()
{
/**The code in this function is only excecuted if the #log_on variable is set*/
/**This funtion takes care of sending the logging data in pieces to avoid disturbing the control loop. 
This problem can be avoided with the use of interruptions for the control loop; however this was not implemented
and could be considered as some future improvement*/  
    if (log_on)
    {
        switch (count){
            case 0: /// #count = 0
                ip_buff = (int) iprom; /// * Define @p ip_buff for storing #i_prom
                vp_buff = (int) vprom; /// * Define @p vp_buff for storing #v_prom
                tp_buff = (int) tprom; /// * Define @p tp_buff for storing #tprom
                qp_buff = (unsigned) ((qprom * 10) + 0.05); /// Define @p qp_buff for storing #qprom @c * @c 10*/
                LINEBREAK;
                break;
            case COUNTER: /// #count = #COUNTER
                itoa(log_buffer,minute,10); /// * Convert #minute into a string and store it in #log_buffer
                break;
            case COUNTER - 1: /// Next cycle
                if (minute < 10) UART_send_char('0'); /// * If #minute is smaller than 10 send a '0'
                else UART_send_char(log_buffer[0]); /// * Else, send #log_buffer[0]
                break;
            case COUNTER - 2: /// Next cycle
                if (minute < 10) UART_send_char(log_buffer[0]); /// * If #minute is smaller than 10 send #log_buffer[0]
                else UART_send_char(log_buffer[1]); /// * Else, send #log_buffer[1]
                break;
            case COUNTER - 3: /// Next cycle
                UART_send_char(colons); /// * Send a colons character
                break;
            case COUNTER - 4: /// Next cycle
                memset(log_buffer, '0', 8); /// * Clear #log_buffer
                break;
            case COUNTER - 5: /// Next cycle
                itoa(log_buffer,second,10); /// * Convert #second into a string and store it in #log_buffer
                break;
            case COUNTER - 6: /// Next cycle
                if (second < 10) UART_send_char('0'); /// * If #second is smaller than 10 send a '0'
                else UART_send_char(log_buffer[0]); /// * Else, send #log_buffer[0]
                break;
            case COUNTER - 7: /// Next cycle
                if (second < 10) UART_send_char(log_buffer[0]); /// * If #second is smaller than 10 send #log_buffer[0]
                else UART_send_char(log_buffer[1]); /// * Else, send #log_buffer[1]
                break;
            case COUNTER - 8: /// Next cycle
                UART_send_char(comma); /// * Send a comma character
                break;
            case COUNTER - 9: /// Next cycle
                memset(log_buffer, '0', 8); /// * Clear #log_buffer
                break;
                case COUNTER - 10: /// Next cycle
                UART_send_char(C_str); /// * Send a 'C'
                break;
            case COUNTER - 11: /// Next cycle
                UART_send_char(cell_count); /// * Send a #cell_count variable
                break;
            case COUNTER - 12: /// Next cycle
                UART_send_char(comma); /// * Send a comma character
                break;
            case COUNTER - 13: /// Next cycle
                UART_send_char(S_str); /// * Send an 'S'
                break;
            case COUNTER - 14: /// Next cycle
                itoa(log_buffer,(int)state,10); /// * Convert #state into a string and store it in #log_buffer
                break;
            case COUNTER - 16: /// Next cycle
                UART_send_char(log_buffer[0]); /// * Send #log_buffer[0]
                break;
            case COUNTER - 17: /// Next cycle
                if (state >= 10) UART_send_char(log_buffer[1]); /// * If #state is bigger than 10, send #log_buffer[0]
                break;   
            case COUNTER - 18: /// Next cycle
                UART_send_char(comma); /// * Send a comma character
                break;
            case COUNTER - 19: /// Next cycle
                UART_send_char(V_str); /// * Send a 'V'
                break;
            case COUNTER - 20: /// Next cycle
                itoa(log_buffer,vp_buff,10); /// * Convert @p vp_buff into a string and store it in #log_buffer
                break;
            case COUNTER - 21: /// Next cycle
                UART_send_char(log_buffer[0]); /// * Send #log_buffer[0]
                break;
            case COUNTER - 22: /// Next cycle
                UART_send_char(log_buffer[1]); /// * Send #log_buffer[1]
                break;
            case COUNTER - 23: /// Next cycle
                UART_send_char(log_buffer[2]); /// * Send #log_buffer[2]
                break;
            case COUNTER - 24: /// Next cycle
                if (vp_buff >= 1000) UART_send_char(log_buffer[3]); /// * If @p vp_buff is bigger than 1000, send #log_buffer[3]
                break;
            case COUNTER - 25: /// Next cycle
                UART_send_char(comma); ///* Send a comma character
                break;
            case COUNTER - 26: /// Next cycle
                memset(log_buffer, '0', 8);  /// * Clear #log_buffer
                break;
            case COUNTER - 27: /// Next cycle
                UART_send_char(I_str); /// * Send an 'I'
                break;
            case COUNTER - 28: /// Next cycle
                itoa(log_buffer,ip_buff,10); /// * Convert @p ip_buff into a string and store it in #log_buffer
                break;
            case COUNTER - 29: /// Next cycle
                UART_send_char(log_buffer[0]); /// * Send #log_buffer[0]
                break;
            case COUNTER - 30: /// Next cycle
                UART_send_char(log_buffer[1]); /// * Send #log_buffer[1]
                break;
            case COUNTER - 31: /// Next cycle
                UART_send_char(log_buffer[2]); /// * Send #log_buffer[2]
                break;
            case COUNTER - 32: /// Next cycle
                if (ip_buff >= 1000) UART_send_char(log_buffer[3]); /// * If @p ip_buff is bigger or equal to 1000, send #log_buffer[3]
                break;
            case COUNTER - 33: /// Next cycle
                UART_send_char(comma); ///* Send a comma character
                break;
            case COUNTER - 34: /// Next cycle
                memset(log_buffer, '0', 8);  /// * Clear #log_buffer
                break;
            case COUNTER - 35: /// Next cyclev
                UART_send_char(T_str); /// * Send a 'T'
                break;
            case COUNTER - 36: /// Next cycle
                itoa(log_buffer,tp_buff,10); /// * Convert @p tp_buff into a string and store it in #log_buffer
                break;
            case COUNTER - 37: /// Next cycle
                UART_send_char(log_buffer[0]); /// * Send #log_buffer[0]
                break;
            case COUNTER - 38: /// Next cycle
                UART_send_char(log_buffer[1]); /// * Send #log_buffer[1]
                break;
            case COUNTER - 39: /// Next cycle
                UART_send_char(log_buffer[2]); /// * Send #log_buffer[1]
                break;
            case COUNTER - 40: /// Next cycle
                if (tp_buff >= 1000) UART_send_char(log_buffer[3]);  // * If @p tp_buff is bigger or equal to 1000, send #log_buffer[3]
                break;
            case COUNTER - 41: /// Next cycle
                UART_send_char(comma); ///* Send a comma character
                break;
            case COUNTER - 42: /// Next cycle
                memset(log_buffer, '0', 8);  /// * Clear #log_buffer
                break;
            case COUNTER - 43: /// Next cycle
                UART_send_char(Q_str); /// * Send a 'Q'
                break;
            case COUNTER - 44: /// Next cycle
                utoa(log_buffer,qp_buff,10); /// * Convert @p qp_buff into a string and store it in #log_buffer
                break;
            case COUNTER - 45: /// Next cycle
                UART_send_char(log_buffer[0]); /// * Send #log_buffer[0]
                break;
            case COUNTER - 46: /// Next cycle
                if (qp_buff >= 10) UART_send_char(log_buffer[1]); /// * If @p qp_buff is bigger or equal to 10, send #log_buffer[1]
                break;
            case COUNTER - 47: /// Next cycle
                if (qp_buff >= 100) UART_send_char(log_buffer[2]); /// * If @p qp_buff is bigger or equal to 100, send #log_buffer[2]
                break;
            case COUNTER - 48: /// Next cycle
                if (qp_buff >= 1000) UART_send_char(log_buffer[3]); /// * If @p qp_buff is bigger or equal to 1000, send #log_buffer[3]
                break;
            case COUNTER - 49: /// Next cycle
                if (qp_buff >= 10000) UART_send_char(log_buffer[4]); /// * If @p qp_buff is bigger or equal to 10000, send #log_buffer[4]
                break;  
            case COUNTER - 50: /// Next cycle
                UART_send_char('<'); /// * Send a '<'
                break;    
        } 
    }
    if (!log_on) RESET_TIME(); /// If #log_on is cleared, call #RESET_TIME()
}
/**@brief This function read the ADC and store the data in the coresponding variables
*/
void read_ADC()
{
    float opr = 0; /// Define @p opr to store the operations inside the function
    AD_SET_CHAN(V_CHAN); /// Select the #V_CHAN channel usign #AD_SET_CHAN(x)
    AD_CONVERT(); /// Make the conversion by calling #AD_CONVERT()
    AD_RESULT(); /// Store the result in #ad_res with #AD_RESULT()
    //v = ad_res * 1.23779; //* 1.2207;    
    opr = (float)(1.28655 * ad_res); /// Apply the operation @code opr = ad_res * [(R1+R2)/(R1)] * [(Vref)/(2^12)] = ad_res * (1051/1000) * (5014/4096) @endcode
    v = opr; /// Make #v equal to @p opr
    AD_SET_CHAN(I_CHAN); /// Select the #I_CHAN channel usign #AD_SET_CHAN(x)
    AD_CONVERT(); /// Make the conversion by calling #AD_CONVERT()
    AD_RESULT(); /// Store the result in #ad_res with #AD_RESULT()
    opr = (float)(1.22412 * ad_res); /// Apply the operation @code opr = [(Vref)/(2^12)] * ad_res @endcode
    //i = opr;
    opr = opr - 2525; /// Apply the operation @code opr = opr - 2525 @endcode
    if (state == CHARGE | state == POSTCHARGE){
        opr = -opr; ///If the #state is #CHARGE or #POSTCHARGE change the sign of the result
    }
    i = (float)(opr * 2.5); /// Apply the operation @code opr = opr * 2.5 @endcode which is the sensitivity of the ACS723LL
    AD_SET_CHAN(T_CHAN); /// Select the #T_CHAN channel usign #AD_SET_CHAN(x)
    AD_CONVERT(); /// Make the conversion by calling #AD_CONVERT()
    AD_RESULT(); /// Store the result in #ad_res with #AD_RESULT()
    opr = (float)(1.22412 * ad_res); /// Apply the operation @code opr = [(Vref)/(2^12)] * ad_res @endcode
    opr = (float)(1866.3 - opr); /// Apply the operation @code opr = 1866.3 - opr @endcode. Sensor STLM20 Datasheet p.6
    t = (float) (opr/1.169); /// Apply the operation @code t = opr/1.169 @endcode. Sensor STLM20 Datasheet p.6
}
/**@brief This function is the PI control loop
*/
void control_loop()
{   
    if(!cmode) /// If #cmode is cleared then
    {
        pid(v, vref + 18);  /// * The #pid() function is called with @p feedback = #v and @p setpoint = #vref
    }else /// Else,
    {
        pid(i, iref); /// * The #pid() function is called with @p feedback = #i and @p setpoint = #iref
    }
    set_DC(); /// The duty cycle is set by calling the #set_DC() function
}
/**@brief This function control the timing
*/
void timing()
{
    if(count) /// If #count is other than zero, then 
    {
        count--; /// * Decrease it
    }else /// Else,
    {
        count = COUNTER; /// * Make #count equal to #COUNTER
        if(second < 59) second++; /// * If #second is smaller than 59 then increase it
        else{second = 0; minute++;} /// * Else, make #second zero and increase #minute
    }
}
/**@brief This function calculate the averages
*/
void calculate_avg()
{
    switch(count)
    {
        case COUNTER: /// If #count = #COUNTER
            iprom = 0; /// * Make #iprom zero
            vprom = 0; /// * Make #vprom zero
            tprom = 0; /// * Make #tprom zero
            break;
        case 0: /// If #count = 0
            iprom /= COUNTER; /// * Divide the value stored in #iprom between COUNTER to obtain the average
            vprom /= COUNTER; /// * Divide the value stored in #vprom between COUNTER to obtain the average
            tprom /= COUNTER; /// * Divide the value stored in #tprom between COUNTER to obtain the average
            qprom += (iprom/3600); /// * Divide #iprom between 3600 and add it to #qprom to integrate the current over time
            #if (NI_MH_CHEM)  
            if ((int) vprom > vmax) vmax = (int) vprom; /// * If is the chemistry is Ni-MH and #vprom is bigger than #vmax then set #vmax = #vprom
            #endif
            break;
        default: /// If #count is not any of the previous cases then
            iprom += i; /// * Accumulate #i in #iprom
            vprom += v; /// * Accumulate #v in #vprom
            //tprom += t; /// * Accumulate #t in #tprom
            tprom += dc * 1.953125; // TEST FOR DC
            break;
    }   
}
/**@brief This function activate the UART reception interruption 
*/
void UART_interrupt_enable()
{
    char clear_buffer = 0; /// * Define the variable @p clear_buffer, used to empty the UART buffer
    while(RCIF){
        clear_buffer = RC1REG; /// * Clear the reception buffer and store it in @p clear_buffer
    }
    RCIE = 1; /// * Enable reception interrupts
    TXIE = 0; // * Disable transmision interrupts
}
/**@brief This function send one byte of data to UART
* @param bt character to be send
*/
void UART_send_char(char bt)  
{
    while(0 == TXIF)
    {
    }/// * Hold the program until the transmission buffer is free
    TX1REG = bt; /// * Load the transmission buffer with @p bt
}
/**@brief This function receive one byte of data from UART
* @return RC1REG reception register
*/
char UART_get_char()   
{
    if(OERR) /// If there is error 
    {
        CREN = 0; /// * Clear the error 
        CREN = 1; /// * Restart
    }
    
    while(!RCIF);  /// Hold the program until the reception buffer is free
    
    return RC1REG; /// Receive the value and return it
}
/**@brief This function send a string using UART
* @param st_pt pointer to string to be send
*/
void UART_send_string(char* st_pt)
{
    while(*st_pt) /// While there is a byte to send
        UART_send_char(*st_pt++); /// * Send it usign #UART_send_char() and then increase the pointer possition
}
/**@brief This function convert a number to string and then send it using UART
* @param value integer to be send
*/
void display_value(int value)
{   
    char buffer[6]; /// * Define @p buffer to used it for store character storage
    itoa(buffer,value,10);  /// * Convert @p value into a string and store it in @p buffer
    UART_send_string((char*)buffer); /// * Send @p buffer using #UART_send_string()
}
/**@brief This function activate the desired relay in the switcher board according to the value
* of #cell_count
*/
void Cell_ON()
{
//    if (cell_count == '1') /// If cell_count = '1'
//    {
//        CELL1_ON; /// * Turn ON cell #1 by calling #CELL1_ON
//        CELL2_OFF; /// * Turn OFF cell #2 by calling #CELL2_OFF
//        CELL3_OFF; /// * Turn OFF cell #3 by calling #CELL3_OFF
//        CELL4_OFF; /// * Turn OFF cell #4 by calling #CELL4_OFF
//    }else if (cell_count == '2')
//    {
//        CELL1_OFF; /// * Turn OFF cell #1 by calling #CELL1_OFF
//        CELL2_ON; /// * Turn ON cell #2 by calling #CELL2_ON
//        CELL3_OFF; /// * Turn OFF cell #3 by calling #CELL3_OFF
//        CELL4_OFF; /// * Turn OFF cell #4 by calling #CELL4_OFF 
//    }else if (cell_count == '3')
//    {
//        CELL1_OFF; /// * Turn OFF cell #1 by calling #CELL1_OFF
//        CELL2_OFF; /// * Turn OFF cell #2 by calling #CELL2_OFF
//        CELL3_ON; /// * Turn ON cell #3 by calling #CELL3_ON
//        CELL4_OFF; /// * Turn OFF cell #4 by calling #CELL4_OFF    
//    }else if (cell_count == '4')
//    {
//        CELL1_OFF; /// * Turn OFF cell #1 by calling #CELL1_OFF
//        CELL2_OFF; /// * Turn OFF cell #2 by calling #CELL2_OFF
//        CELL3_OFF; /// * Turn OFF cell #3 by calling #CELL3_OFF
//        CELL4_ON; /// * Turn ON cell #4 by calling #CELL4_ON    
//    }
}
/**@brief This function deactivate all relays in the switcher board
*/
void Cell_OFF()
{
//    CELL1_OFF; /// * Turn OFF cell #1 by calling #CELL1_OFF
//    CELL2_OFF; /// * Turn OFF cell #2 by calling #CELL2_OFF
//    CELL3_OFF; /// * Turn OFF cell #3 by calling #CELL3_OFF
//    CELL4_OFF; /// * Turn OFF cell #4 by calling #CELL4_OFF  
}
