DeltaLabo/cell_charger_discharger/(commit log)

2018-07-10 Timer0 is working. Some code was included in the main to test that it can count 1 second. WDT needs to be deactivated in order to make this work because they share the same prescaler.
2018-07-10 PWM of 8 bits is ready, out of the oven. Only an 8 bit register to set the DC, from 0 to 100 without change of resolution. The price to pay was changing frequency to 250kHz.
2018-07-10 ADC is working, ready FI BUM DEM. However, the ouput is a little crazy
2018-07-12 Now the measurements of the ADC are correct, the control loop is now at 1kHz. I'm about to make changes to the PID stuff.
    [hardware.c, main.c]
2018-07-13 Ready for test in the computer usign LabView. Tunning of the controller is not finish and change to switch case is requiered too
2018-07-17 Tested with Labview, test at 200Khz create some sound problems
    [hardware.c, main.c, state_machine.c]
2018-07-17 Test with 125 Khz, something is wrong but now is different, it doesn't even start
    [hardware.c]
2018-07-20 A problem with the transition between CC and CV, I will solve it. The rest is better than anytime before
    [hardware.c, state_machine.c]
2018-08-01 Some incremental stepping in the ki when CV is reached. Also right now is running with FCCM of the mosfet driving chip activated.
2018-08-01 Very good behaviour at low current. Incremental of the duty cycle can be a good idea.
2018-08-03 First commit from MSI Laptop. nothing special added, just some cleaning. Next step is the unification the state machine into a switch case structure with a function for each state.
2018-08-03 CHARGE DISCHARGE AND PRECHARGE IMPLEMENTED
2018-08-03 DC res calculations implemented as switch and function
2018-08-03 All Parameter definition for LI-Ion changed to switch-case
2018-08-03 Forgot to stage the Main.c in previous commit
2018-08-03 Error of charging after discharge is not solved, but still is quite good.
    [main.c, state_machine.c]
2018-08-03 Error was reduce to 200 is a big change so better take a look at it again
    [hardware.c, main.c]
2018-08-04 The error was fixed adding capacitors to the output of the regulator and the branches.
    [main.c, state_machine.c]
2018-08-05 Timing is changed to use 2ms period and the results are not so good, for some reason the constants are not working anymore,
    [hardware.c, main.c, state_machine.c]
2018-08-06 Just testing, the timing was increased to 4 ms per cycle, but still gives error, there is something very slow....
    [hardware.c, main.c]
2018-08-06 I made many changes, and was able to solve the things about timing errors, unfortunately that leads to a period of 4 ms between control cycles, which is not good.
    [hardware.c, main.c, state_machine.c]
2018-08-07 Correction of the initialization, everything now is move to Defeine_param()
    [hardware.c, main.c, state_machine.c]
2018-08-08 Change to floats, and goto was added, stop and restart the UART interruptions
2018-08-08 Just set the voltage offset for this particular case
2018-08-11 Fixed the state machine, by changing the variable previous_state to prev_or_next_state
    [state_machine.c]
2018-08-11 More documentation, I just found an error in the state machine, after the wating it does not come back to the usual operation
    [hardware.c, main.c]
2018-08-11 Reverse the change in prev_state, to much change led to failure...
    [state_machine.c]
2018-08-29 Include temperature measurements, Choke filter was install, and worked perfect
2018-08-30 First version of Ni-MH, the resistor need to be reduced to 1ohm or something like that
2018-08-30 Timing is directly set to 4ms with timer 0. Log works ok now
2018-08-31 Capacity now works OK, there was a timing problem when using ltoa, so i decided to use utoa instead, so now maximum capacity that can be recorded is 0xFFFF
    [hardware.c, main.c, state_machine.c]
2018-09-01 Inlcude a termination for the log, and reset the capacity buffer
    [hardware.c, main.c, state_machine.c]
2018-09-02 Several change. Serial interrupt was changed to avoid interference with the STANDBY state. Header guard in hardware.h. Change of waiting string to W[0-9]+W. Include timeout for charging
    [hardware.c, main.c, state_machine.c]
2018-09-02 Change capacity of Ni_MH to 2000. Include small changes in documentation
2018-09-07 Include temperature instead of duty cycle. Incude Cell number and state number in waiting and DC_res states log
2018-09-07 It seems there is a problem still with the PS_DC_res but I don't know where it comes from, testing again to see. Changed the way the states are sent in the log, because it was bad, it only worked for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
    [hardware.c, state_machine.c]
2018-09-19 Clear the code in the interruption for the main.c
2018-09-24 Counter for end of charge and end of discharge were eliminated. A lot of documentation was added. Now still in hardware.c
2018-09-24 Change to only one header file called "charger_discharger.h" also the hardware.c was changed to charger_discharger
2018-09-27 More documentation, now switching to new program
2018-09-27 Initial approach to the new board, not tested yet
2018-09-28 To work with LIPO the CV_kp was changed from 0.4 to 0.2 and the CV_ki was changed from 0.5 to 0.4. Also there was an error in the fCHARGE, should be implemented in the other program
    [charger_discharger.h, state_machine.c]
2018-10-01 Change in the logging, errror in minutes after 99 was solved
    [charger_discharger.c, state_machine.c]
2018-10-12 Working perfect! Taking out all the bias in the ADC, got to recalibrate! SET_CHAR and SET_DISC were backwards. And STOP_CONVERTER() also. I removed the HACKS for the previous board.
2018-10-14 The outputs for the cells were fixed. Some issue with settling time, it was too fast. Voltage measurement was corrected, now there is no voltage divider. The average of the values is now done with CO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
    [charger_discharger.c, charger_discharger.h, main.c, state_machine.c]
2019-02-21 Increase DC max to 0.8 it was to low so it gave problems when there is too much voltage drop. I change the main so it always check the CV value.
    [charger_discharger.c, charger_discharger.h, main.c]
2019-07-03 Include .vscode in gitnore and make several change that almost let it run good. It shows a warning of High temperature
2019-07-04 Almost done. The charge is working but discharge is under test. For cancelling the process now is neccessary to press "c" instead of ESC. This is because the arrows are detected as ESC for some reaso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
2019-07-04 Change Labview program to provide a "c" instead of ESC while operating
2019-07-05 Problem with the current value
    [charger_discharger.c, charger_discharger.h, main.c, state_machine.c]
2019-07-07 Only the resistance part is peding
2019-07-07 New way to get the resistance
2019-07-10 Solved the two errors
    [charger_discharger.c, charger_discharger.h]
2019-07-10 Solve the problem of printing by usign utoa again, solve the problem of vmax by putting it as part of the log.
    [charger_discharger.c, charger_discharger.h]
2019-07-14 Changes in documentation
    [chargerDischarger.V5.brd, chargerDischarger.V5.sch, chargerDischarger.V5.xlsx]
2020-10-28 new board versions
    [cellSwitcherPbanLiIonV6.xls, cellSwitcherPbanNiMHV6.xls, cellSwitcherV6.xlsx, cellSwitcher_li_ion_V6.brd, cellSwitcher_li_ion_V6.sch, cellSwitcher_ni_mh_V6.brd, cellSwitcher_ni_mh_V6.sch, chargerDischarger.V6.brd]
2023-02-17 from bitbucket
    [chargerDischarger.V5.brd, chargerDischarger.V5.sch]
2023-02-21 PCB_PDFs
    This contains the schematics and boards of the charger/discharger
2023-12-21 problem with little endian
    [charger_discharger.c, charger_discharger.h, main.c]
2023-12-21 checksum is not working
    [charger_discharger.c, charger_discharger.h]
2023-12-22 working_version
    new constant current for charge and discharge
2024-02-22 Charge baterry functioning
    Changes for the charge function to work have been made
2024-03-01 Progress on implementing discharge
    Friday first of march. Advanced in implementing discharge and changes of the reset and idel state.
    [charger_discharger.c, state_machine_b.c]
2024-03-19 cambios de pid y algo de estados
    todavia peta de vez en cuando
2024-04-18 <converter configuration and interrupt work
    converter configuration is now functional, further testing is needed.
    a function called interrupt enable was done for trying to solve next state and next cell errors
    cargue variable is now a float and is seem to be working well, further testing is needed
    [charger_discharger.c, charger_discharger.h, main.c, state_machine_b.c]
2024-04-19 Test results directory
    In this directory, csvs with the data gather form test are going to be uploaded for its future plot
    [Discharge.csv]
2024-04-23 Test for raw data interpretation
    [Charge2.csv, Discharge3.csv]
2024-05-16 Next State, Next cell and Next Repetition Solved
    This patch solve the interruption problem that didnt let the nextState, nextRepetition and nextCell work the way it was intended.
    Future patches will be focus on cleanin the code, properly commented and quality of life updates such as the implementation of default values for bothe NMH and LI k values for the pid.
    [charger_discharger.c, charger_discharger.h, main.c, state_machine_b.c]
2024-08-19 Revision on next state failure
    Se ponen algunas constantes y se quitan los #if y #else para que funcione con cualquier batería. Se trabaja en la detección de errores de comunicación
    [charger_discharger.c, charger_discharger.h, main.c, state_machine_b.c]
2024-08-29 Next state fixed
    Changes on the definition of the messages for next state, next cell and reset. Change in how the interruption of UART is being managed.
    [charger_discharger.c, charger_discharger.h, main.c, state_machine_b.c]
2024-08-29 wait time between repetitons corrected
    [charger_discharger.c, charger_discharger.h, state_machine_b.c]
2024-09-02 Documentation on frame changes
    Changes on converting settings and action commands
2024-09-19 Advances on a python interface for testing and calibration
    Advances on a python interface for testing and calibration
2025-02-05 Delete Test_Result/Charge2.csv
    Deleted old test results
    [Charge2.csv]
2025-02-05 Delete Test_Result/DC Resistance_17_05_24_15_07_55.csv
    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
    [DC Resistance_17_05_24_15_07_55.csv]
2025-02-05 Delete Test_Result/DC Resistance_17_05_24_16_44_24.csv
    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
    [DC Resistance_17_05_24_16_44_24.csv]
2025-02-05 Delete Test_Result/Discharge3.csv
    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
    [Discharge3.csv]
2025-02-05 Delete Test_Result/Slow_Discharge.csv
    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
    [Slow_Discharge.csv]
2025-02-05 Upload test results from 05-02-2025 at Costa Rica
    [charge_04_02_25_13_50_12.csv, discharge_04_02_25_14_59_07.csv]
2025-02-05 More test results
    [charge_04_02_25_11_15_21.csv, discharge_04_02_25_12_41_10.csv]
2025-02-13 DC resistance patch
    [precharge_10_02_25_12_58_40.csv]
2025-02-13 test results for li-ion
    [DC Resistance_13_02_25_14_34_51.csv, charge_26_09_24_14_43_33.csv, discharge_12_02_25_14_23_49.csv]
2025-02-13 Test Li-ion data
    [charge_04_02_25_11_15_21.csv, charge_04_02_25_13_50_12.csv, discharge_04_02_25_12_41_10.csv, discharge_04_02_25_14_59_07.csv, precharge_10_02_25_12_58_40.csv]
2025-02-20 Python Calibration Programm Added
    [data_log_13_2025-02-20_16-41-57.csv, data_log_3_2025-02-20_14-50-45.csv, data_log_7_2025-02-18_17-53-08.csv]
2025-02-27 New DC_Resistance test implemented based on IEC 61960-3
    Changed the test for DC-Resistance to one based on IEC 61960-3. Also, added a dc_res post processing file.
2025-02-27 Fixed headers on script
    [dc_resistance_post.py]
2025-06-09 lo ultimo que hizo Alex
